fletchmeyers/Automated_Watering_System/README.md

A wireless garden monitoring system using a Raspberry Pi and one or more
radio sensor nodes (CircuitPython and/or Arduino) communicating over RFM69.
The Pi polls nodes, logs data to SQLite, and serves it through a Flask API
behind a Cloudflare Tunnel to a live dashboard on GitHub Pages.

# Setup Guide

This is the current setup as actually deployed — rewritten after a full
disaster-recovery rebuild surfaced a lot of drift from the original guide.
If you're setting up a fresh Pi (new SD card, new hardware), use the
Quick setup below; Parts 1–4 document what it does, step by step. If something here doesn't match reality, it's more likely
this doc that's stale than your memory of how things work — please fix it
inline as you find gaps, the same way this rewrite happened.

---

## Repo layout

```
Automated_Watering_System/
  raspberrypi/     — Pi-side code: radio_nodes.py, flask_api.py, db.py; the Pi's
                     sensors.db and logs also live here (gitignored)
  dashboard/       — the web dashboard (index.html, JS, CSS) served by GitHub Pages
  circuitpython/   — the garden Pico (node 1), laid out like its CIRCUITPY
                     drive: code.py and modules at the top, libraries in lib/
  arduino/         — PlatformIO project for Arduino-based nodes (node 2+)
  deploy/          — systemd unit templates and install.sh
  tests/           — software_tests (pytest) and hardware_tests per board
                     (run them all with: python -m pytest tests/software_tests;
                     the API's need Flask, so they run on the Pi and are
                     skipped elsewhere)
  index.html       — redirects GitHub Pages visitors to dashboard/index.html
```

To update the Pico, copy the contents of `circuitpython/` onto its
CIRCUITPY drive (only the files that changed, usually not `lib/`).

Clone into `~/Automated_Watering_System` on the Pi — every systemd unit,
script, and path reference below assumes this exact location.

## Branches

- **`main`** is the only long-lived branch. GitHub Pages serves the
  dashboard from it, and the Pi's clone tracks it (`git clone <repo-url>`).
- **Sensor data never goes into git.** It lives on the Pi — `raspberrypi/sensors.db`,
  plus the `raspberrypi/data_from_pico.txt` and `raspberrypi/archive/` text logs, all
  gitignored — and reaches the dashboard live through the Flask API.
  (Until October 2026 a cron job pushed `data_from_pico.txt` to a separate
  `update_dashboard_data` branch every 5 minutes; that branch and
  `push_data.sh` are retired.)
- **Workflow for new features**: branch off `main` → develop → open a PR
  into `main` → on the Pi, `git pull` and restart whichever service changed
  (`garden-radio` and/or `garden-api`; if `deploy/` changed, run
  `deploy/install.sh` instead) → confirm it works → delete the
  feature branch. To try a branch on the Pi before merging it, check it out
  there (`git fetch && git checkout <branch>`), then switch back to `main`
  once it's merged.
- **Before deleting a branch on GitHub**, switch your local repo off it
  (`git checkout main && git pull`), then delete the local copy too
  (`git branch -d <branch>`).
- If GitHub Pages' configured source branch (Settings → Pages) ever
  changes, update this section to match — that setting is the actual
  source of truth, this doc is just documentation of it.

## Node IDs

| Node | Hardware | Framework |
|---|---|---|
| 1 | Garden Pico (Pico 2W, solar/car-battery powered) | CircuitPython |
| 2 | Feather M0 | Arduino (PlatformIO) |
| 3+ | any board listed in `nodes.json` (see "Adding or updating a node") | CircuitPython or Arduino |

All nodes share one 915MHz frequency and encryption key — see
`hardware_setup_indoor.py` / `hardware_setup_garden.py` / each
`board_config_*.h`. The key must match exactly across every node and the Pi.

---

## Quick setup (a fresh card)

Works on a Pi 3B or a Pi Zero 2 W. `deploy/setup.sh` does Parts 1–4.

1. **Flash the card** with Raspberry Pi Imager: *Raspberry Pi OS Lite
   (64-bit)*, found under *Raspberry Pi OS (other)*. Lite is the same OS
   without the desktop, which a headless hub doesn't need (the desktop
   costs 200–300 MB of RAM; too much for a Zero 2 W's 512 MB). The full
   OS also works on a Pi 3B; run `sudo raspi-config nonint
   do_boot_behaviour B1` after setup so it boots to the console. In the
   Imager's settings (the gear / "Edit settings"), set the
   hostname, username and password, Wi-Fi, time zone, and turn on SSH.
2. **Copy a backup over**, if you have one (see Disaster recovery). From
   the PC, once the new Pi is on the network:
   ```bash
   scp garden_backup_<date>.tar.gz <user>@<new-pi-ip>:~
   ```
3. **On the new Pi:**
   ```bash
   sudo apt update && sudo apt install -y git
   git clone https://github.com/fletchmeyers/Automated_Watering_System.git ~/Automated_Watering_System
   ~/Automated_Watering_System/deploy/setup.sh --restore ~/garden_backup_<date>.tar.gz --wittypi
   sudo reboot
   ```
   Leave out `--restore` for a brand-new hub with no data or tunnel yet
   (then set up the tunnel per Part 4), and `--wittypi` if there's no
   Witty Pi HAT. The script is safe to re-run if it stops partway.

**Only run one hub at a time.** Two Pis polling the same nodes would
collide on the radio, and two copies of one Cloudflare tunnel would split
the dashboard's requests between them.

## Part 1: OS-level dependencies (not in git — install fresh every time)

None of this is captured by cloning the repo. Do this before anything else
on a fresh Pi:

```bash
sudo apt update
sudo apt install -y swig liblgpio-dev sqlite3
```

**Enable SPI** (required for the radio; off by default on a fresh OS image):

```bash
sudo raspi-config
```

Interface Options → SPI → Yes → reboot.

Confirm it took effect:

```bash
ls -la /dev/spidev0.0
```

## Part 2: Two separate Python environments

These are genuinely separate on purpose — one needs hardware access, the
other doesn't, and mixing them causes `pip install --user` errors (a venv
hides user site-packages).

### 2.1 Radio/hardware venv (for `radio_nodes.py`)

```bash
python3 -m venv ~/env
source ~/env/bin/activate
pip install adafruit-circuitpython-rfm69
```

Verify:

```bash
~/env/bin/python3 -c "import board; print('ok')"
```

### 2.2 Flask API (system Python, no venv)

```bash
deactivate   # if you're still in the venv from above
pip install --user flask flask-cors requests gunicorn --break-system-packages
```

`gunicorn`/`flask` land in `~/.local/bin/` — not on `PATH` by default, so
systemd units below reference full paths rather than bare commands.

## Part 3: systemd services

Four services: `garden-radio` (`radio_nodes.py`, the nodes on the radio),
`garden-wifi` (`wifi_nodes.py`, its counterpart for the nodes on Wi-Fi),
`garden-api` (the Flask API under gunicorn) and `garden-usb` (pulls a
node's backlog when it's plugged in). Templates live in `deploy/`;
`install.sh` fills in your username, installs and enables them, and
(re)starts them all. (`garden-radio` was `garden-sensor`, and
`radio_nodes.py` was `main.py`, until October 2026; `install.sh` removes
the old unit.)
Run it as your normal user — it calls `sudo` itself:

```bash
~/Automated_Watering_System/deploy/install.sh
```

It's safe to re-run after any `git pull` that touches `deploy/`. It also
moves the Pi's data out of the old `indoor/` folder into `raspberrypi/`
if it finds any there (the October 2026 folder rename).

Watch live output:

```bash
sudo journalctl -u garden-radio -f
sudo journalctl -u garden-api -f
sudo journalctl -u garden-wifi -f
sudo journalctl -u garden-usb -f     # nodes plugged in over USB
```

### Weather API keys

`flask_api.py` reads `WEATHERAPI_KEY`, `OPENWEATHERMAP_KEY`,
`TOMORROWIO_KEY` via `os.environ`. Since `garden-api.service` runs under
systemd (not your shell), they live in `/etc/garden-api.env` (readable
only by root, never in git), which the unit loads with `EnvironmentFile=`.
`install.sh` creates it the first time, copying any keys from an older
unit file that had them inline. To edit keys:

```bash
sudo nano /etc/garden-api.env       # one KEY=value per line
sudo systemctl restart garden-api
```

A source with no key configured returns a graceful
"not configured" response rather than erroring, so only set the ones you
actually have keys for.

## Part 4: Cloudflare Tunnel

Not installed by default, and its config lives outside git entirely. This
is the one thing where **losing the credentials file means starting over**
with a brand-new tunnel (new UUID) and re-pointing DNS — so it's worth
backing this up somewhere off the Pi (see Disaster Recovery below).

If restoring an existing tunnel (you have the credentials backed up):

```bash
curl -L --output cloudflared.deb https://github.com/cloudflare/cloudflared/releases/latest/download/cloudflared-linux-arm64.deb
sudo dpkg -i cloudflared.deb
sudo mkdir -p /etc/cloudflared
# copy in: <uuid>.json, cert.pem, config.yml
sudo chmod 600 /etc/cloudflared/<uuid>.json
```

Check `config.yml`'s `credentials-file:` path matches where you actually
put the `.json` — this is the #1 thing that breaks on a restore.

```bash
sudo cloudflared service install
sudo systemctl enable cloudflared
sudo systemctl start cloudflared
```

If starting fully fresh (no backup — creates a **new** tunnel identity):

```bash
cloudflared tunnel login
cloudflared tunnel create garden-api
cloudflared tunnel route dns garden-api api.fletchermeyers.com
```

Then write `config.yml` pointing `service: http://127.0.0.1:5000` at the
Flask API, and proceed with `service install` as above.

Verify end to end:

```bash
curl https://api.fletchermeyers.com/api/health
```

## Part 5: (no cron job or GitHub token needed)

Earlier versions of this guide set up a GitHub push token and a cron job
running `push_data.sh` every 5 minutes. Both are retired: the dashboard
reads data live from the API, and nothing on the Pi pushes to GitHub. The
Pi only needs read access to `git pull`, which a public repo doesn't
require credentials for.

---

## Adding or updating a node

Every node's settings live in the Pi's node list,
**`raspberrypi/nodes.json`**: name, framework (`circuitpython` or
`arduino`), board, Wi-Fi or radio, sense and log intervals, storage (`sd`,
`flash` for Arduino SAMD boards, or `none`), pins, and an optional
`sleep_window`. It's the Pi's own file, not in git (so adding a node never
needs a commit), and it's in both backups (`deploy/backup.sh` and the
nightly USB stick). A fresh Pi starts it from `nodes.example.json`, the two
garden nodes. `radio_nodes.py` takes its node list from it (restart
`garden-radio` after changing it), `wifi_nodes.py` which nodes may connect
over Wi-Fi, the dashboard names and colors (through `/api/nodes`), and
`node_setup.py` builds each node's settings from it. Sensors aren't
listed: both firmwares look for every sensor they know at boot and use
whichever answer.

**Adding a node** — plug the board into the Pi and run:

```bash
cd ~/Automated_Watering_System/raspberrypi
python3 node_setup.py add
```

It asks about the node, with a default for each question (press Enter to
take it): board (skipped when it can tell from what's plugged in),
framework, Wi-Fi or radio, node ID (the lowest one that's free and has no
old readings in the database), name, where it logs, pins (the board's usual
wiring, or your own), how often it reads its sensors, how often it logs
(only with somewhere to log to), RTC and sleep window. Type `b` to go back
a question. At the end it lists every answer with a number: type one to
change it, or press Enter to save. Then it offers to set the board up as
the new node.

**The hardware check** — after setting a board up (new or updated),
`node_setup.py` reads its sensors a few times over USB and lists every one
that answered, with a `!` under any whose readings look wrong: out of
range, a soil sensor at the top of its range or reading as if in air,
readings jumping about (often a noisy USB charger), or a sensor that
stopped answering. A soil sensor that isn't calibrated yet can then take
its dry (or wet) reading on the spot, from about 30 s of live readings
(see "Calibrating soil sensors"). Run the check on its own, with the node
plugged in, with `python3 node_setup.py check`. To check another kind of
sensor, add a row to `CHECKS` in `raspberrypi/sensor_check.py`.

Plain `python3 node_setup.py`
offers the same questions for a board that isn't a node yet. To take a
node off the list (its readings stay): `python3 node_setup.py remove 3`.
Anything the questions don't cover (a `battery` label for the Nodes card,
a different `color`) can be edited in `nodes.json` with `nano`; it's
checked every time it's read.

To update a node to the latest code, plug it into the Pi by USB and run:

```bash
cd ~/Automated_Watering_System/raspberrypi
python3 node_setup.py --dry-run     # see what would change first
python3 node_setup.py               # update it
python3 node_setup.py list          # the nodes in the list
```

It works out which node is plugged in and what it runs. A CircuitPython
board gets the changed files from `circuitpython/` plus the libraries they
use, and a `node_config.py` written from `nodes.json` (and is restarted
from its console if `boot.py` changed). An Arduino board is built with its
settings and flashed. The library `.mpy` files in
`circuitpython/lib` must match the board's CircuitPython major version.

**Switching a board's framework, or giving it another node's ID** — change
`"framework"` in `nodes.json` (`circuitpython` or `arduino`) if needed,
plug it in, and:

```bash
python3 node_setup.py --node 3
```

`nodes.json` says what the node should be, and the script gets the board
there from whatever it runs now. A board without CircuitPython gets
CircuitPython (the version in `nodes.py`, downloaded for its board from
circuitpython.org) before the node code; an Arduino node on a Pico or
Feather RP2040 gets its firmware built with the node's settings and copied
to the board's bootloader drive; the Feather M0 is uploaded over serial.
To reach the bootloader, a board running CircuitPython is restarted from
its console and one running Arduino with a "1200-baud touch". A blank Pico
shows its bootloader drive by itself; otherwise hold BOOTSEL (Pico) or BOOT
(Feather RP2040) as you plug it in.

Boards (`"board"` in `nodes.json`): `pico`, `picow`, `pico2`, `pico2w` and
`feather_rp2040_adalogger` run either framework; `feather_m0`,
`feather_esp32s2` (ESP32-S2 Feather) and `feather_esp32_v2` (ESP32 Feather
V2) are Arduino only. The M0 and ESP32 boards are uploaded over their
serial port: the V2's USB-serial chip resets it for the upload; if the
ESP32-S2 doesn't take the upload (e.g. its factory program ignores the
reset), hold BOOT, tap RESET, release BOOT, and run the script again. On
the RP2 and ESP32 boards the radio uses the board's default SPI pins unless
`spi_sck`/`spi_mosi`/`spi_miso` say otherwise; an SD card on its own bus
(the Adalogger's slot: `sd_sck` 18, `sd_mosi` 19, `sd_miso` 20, `sd_cs` 23)
goes on the RP2 boards' second one. Arduino nodes other than the M0 have no
RTC unless `"rtc": "pcf8523"` is set: their clock is set by the Pi's polls
and nothing is logged after a restart until the first poll, and a sleep
command turns the radio off but keeps the chip awake. A board with
no radio, no I2C sensors or no RTC still runs (USB only), which makes a
bare board easy to test on the bench.

**Wi-Fi, two links, sleep and battery saver** — see
[How nodes reach the Pi](#how-nodes-reach-the-pi-links-sleep-and-battery-saver)
below for every option and command.

**Watchdog** — every node starts the chip's watchdog before it sets up its
radio, sensors and SD card, and feeds it on every pass of its loop, with
every packet it sends, and before anything that waits (joining Wi-Fi,
reaching the Pi). If anything stops the code for too long, such as a
corroded sensor hanging the I2C bus, the board resets itself and carries
on. After a watchdog reset its console says
`[WATCHDOG] Restarted: the code had stopped`.

- **CircuitPython** (`circuitpython/node_watchdog.py`): 8 s. If the code
  crashes it prints the error and resets 5 s later. Ctrl+C at the console
  turns the watchdog off until the next restart, so the console and
  `node_setup.py` work as before; to work at the console for a while
  without it, put an empty file named `no_watchdog` on the CIRCUITPY drive
  (and delete it before the node goes back outside).
- **Arduino** (`arduino/src/node_watchdog.cpp`, the Adafruit SleepyDog
  library): 8 s, or 16 s on the M0 (its Wi-Fi module can take 8 s to join).
  A crash freezes the chip, which the watchdog then resets (an ESP32
  restarts by itself anyway). The M0's standby sleep lasts minutes between
  readings, so the watchdog is paused for standby and resumed on waking;
  the other boards stay awake while "asleep" and keep feeding it. Build
  with `-D NO_WATCHDOG` to leave it off for bench debugging.

**What a node noted** (CircuitPython nodes, `circuitpython/node_events.py`) —
a node keeps a note on its SD card each time it starts (why it restarted:
power on, watchdog or reset; its CircuitPython version; whether USB was
connected), crashes (the end of the error), is stopped at the console, takes
a sensor offline or brings it back, or switches radio format. The radio gets
notes of its own: when a send fails (the radio library returns False, or
raises an error) and when sends work again, with how many failed; and when
nothing at all has been heard over the radio for 10 minutes (the Pi polls
every minute), and when it's heard again. Together they say which way a
link that went quiet was failing: sending, hearing, or neither (then look
at power or range). The notes ride along with its readings,
so the next radio sync or USB pull brings them to the Pi, which keeps them
out of the readings and adds them to `raspberrypi/node_events.txt`:

    tail -n 30 ~/Automated_Watering_System/raspberrypi/node_events.txt

    2026-10-25T12:03:11  node 1  started, reset reason POWER_ON, CircuitPython 10.2.1, no USB

They're also in the log of whichever service brought them in (`garden-radio`
or `garden-usb`) as `[EVENT] Node 1 at ...`. A packet the radio loop can't
read is logged with its size and first bytes (`Bad packet (36 bytes,
starting 85 a1 74 ...)`), so it can be traced to a node.

**A sensor at a time** (`circuitpython/sense_cycle.py`, and `sense_cycle_step()`
in `arduino/src/packet_protocol.cpp`)
— the node reads its sensors one per pass of its loop and checks the radio
in between, so a command arriving mid-cycle waits for one sensor read at
most, not the whole cycle (some reads are slow: the light sensor waits for
a fresh measurement, and a corroded connection drags). Polls get the last
complete set of readings meanwhile. Without this, a node with several I2C
sensors answered pings late (a ping waits 1.5 s) though polls, which retry,
still got through. (Arduino nodes already catch every packet on the radio's
interrupt, through RadioHead, but can't send the answer from inside it, so
they too answer between reads.)

**Sensors with bad connections** (`circuitpython/sensor_guard.py`,
`arduino/src/sensor_guard.cpp`) — the watchdog catches a sensor that hangs
the code outright; this catches one that keeps failing or dragging (pins
going corroded, say) without stopping it. A sensor whose read fails, or
takes over 1 s, **3 times in a row** is taken offline: the node stops
reading it, so the sensors that still work (and the radio) aren't held up.
It tries it again after 10 minutes, 30 minutes, then every hour, and one
good read brings it back; restarting the node tries everything straight
away. The node lists its offline sensors with every poll
(`{"t":"off","s":"sht,s1"}`), the Pi keeps them in `node_info.json` (and
says so in its log), and the dashboard puts a red "Offline since ..."
banner on the sensor's card and lists them in the node's row. The node's
console says `[SENSOR] sht offline: 3 bad reads in a row (the last took
2.3 s)`. The VOC sensor's temperature/humidity compensation uses the SHT40
reading it just took rather than reading the SHT40 again, so a bad SHT40
doesn't drag it down too. A failed read is one the library reports (an
exception in CircuitPython; on Arduino, the SHT40 saying so, 65535 from a
soil sensor, NaN from the battery gauge or power monitors, 0 from the VOC
sensor); the light sensor has no failure value on Arduino, so only slow
reads count for it there. Arduino nodes time their retries on the node's
clock, which keeps counting through the M0's standby sleep.

**Calibrating soil sensors** — out of the box the dashboard shows every
soil sensor on one fixed scale (raw 200 = 0%, 1023 = 100%), which suits
few pots. Calibrate a sensor with two readings in its own soil (not air or
a jar of water: soil reads well inside that range, and differently for
different soils): "dry" while the plant is due for watering, and "wet"
30-60 minutes after watering.

The Pi does it by itself for a soil sensor it hasn't seen before (on a new
node, or a new seesaw on an existing one): put the sensor in dry soil,
wait a few minutes, then water it thoroughly. `garden-api` checks every 5
minutes; it sees the watering as a jump in the readings, takes dry from
just before it and wet from 30-60 minutes after it, and saves both. Until
then the dashboard shows that sensor's gauge in purple with its raw reading
and what it's waiting for ("water it", or "done ~14:20"). Start it for a
sensor by hand (after swapping one, say) with
`python3 node_setup.py calibrate 3 s1 auto`; sensors that were already
there when this first ran are left alone. Or set either end yourself:

    python3 node_setup.py calibrate 3 s1 dry                 # median of the last hour
    python3 node_setup.py calibrate 3 s1 wet --minutes 20
    python3 node_setup.py calibrate 3 s1 dry --until 18:30   # the hour before 18:30
    python3 node_setup.py calibrate 3 s1 dry --value 940     # a reading you already know
    python3 node_setup.py calibrate 3 s1 clear               # back to the fixed scale

It shows the readings it found (how many, the median and how spread out
they are) and asks before saving them to nodes.json (`"soil": {"s1": {"dry":
940, "wet": 610}}`); the dashboard then shows that sensor's dry reading as
0% and its wet one as 100%. An uncalibrated sensor's label has a `*`, and
hovering over it shows the raw reading. Each reading the nodes send is
already the middle of 9 quick ones, so a noisy USB charger's spikes are
thrown out. The hardware check after setup (`python3 node_setup.py
check`) also offers to take either reading from live readings while the
node is plugged into the Pi.

**Bench testing** — don't add test boards to `nodes.json` (`radio_nodes.py` would
start polling them). `tests/hardware_tests/` has bench files with the same
board IDs (9–12) as Arduino or CircuitPython nodes; point the script at one:

```bash
python3 node_setup.py --nodes ../tests/hardware_tests/bench_nodes_arduino.json --node 9
```

A node with a mistake in `nodes.json` is skipped (with a warning) rather
than stopping `radio_nodes.py` or `node_setup.py` from running for the others.

The dashboard reads node names, colors and battery labels from the Pi's
list too (`/api/nodes`; its built-in list is only used if the Pi can't be
reached), so a new node needs no other edits: restart `garden-radio` on
the Pi so it starts polling a radio node (a Wi-Fi node is picked up by
itself).

Flashing Arduino boards needs PlatformIO on the Pi, a one-time install
(`deploy/setup.sh --platformio` does the same):

```bash
curl -fsSL -o get-platformio.py https://raw.githubusercontent.com/platformio/platformio-core-installer/master/get-platformio.py
python3 get-platformio.py && rm get-platformio.py
~/.platformio/penv/bin/pio pkg install -d ~/Automated_Watering_System/arduino
```

The last line downloads every board's compiler and libraries up front (20+
minutes, mostly RadioHead from its author's slow site), so setting up a
node only has to compile: a few minutes for the first build of each board
type on a Pi 3B, a minute or two after that.

---

## How nodes reach the Pi: links, sleep and battery saver

Everything here is set per node in the Pi's `raspberrypi/nodes.json`, by
the `node_setup.py add` questions or the commands below (each is listed in
[the quick reference](#quick-reference) at the end). In every case **the
Pi is in charge**: a node never sends anything on its own, it only answers
the Pi's commands (poll, ping, sync, info, sleep, ...).

### The two links

| | RFM69 radio | Wi-Fi |
|---|---|---|
| On the Pi | `radio_nodes.py` (`garden-radio` service) | `raspberrypi/wifi_nodes.py` (`garden-wifi` service), TCP port 5006 |
| Range | Long (the garden) | The house Wi-Fi's reach |
| Power on the node | Low: about 16 mA listening | High: tens of mA (M0 WiFi) to 80–130 mA (ESP32) while connected |
| Wiring | An RFM69HCW (FeatherWing or breakout): CS, IRQ (G0 on a breakout), RST and SPI | None: the board's own Wi-Fi chip |
| Readings while the Pi can't be reached | Logged to SD (or M0 flash) and synced later | Lost, unless the node also has storage and the radio |
| Speed | Slow; big packets are split | Fast; one JSON line per packet |

### Which boards can use Wi-Fi

| Board (`"board"`) | Arduino | CircuitPython | Notes |
|---|---|---|---|
| `picow`, `pico2w` | Yes | Yes | |
| `feather_esp32_v2` | Yes | No | |
| `feather_esp32s2` | Yes | No | Needs a u.FL antenna |
| `feather_m0_wifi` (Adafruit 3044) | Yes | No | Wi-Fi takes about 18 KB of the M0's 256 KB flash; setup asks first. It looks like a plain `feather_m0` over USB, so `link` asks which it is |
| `pico`, `pico2`, `feather_m0`, Adalogger | No | No | No Wi-Fi chip |

### Choosing a node's links

`"link"` in `nodes.json` is one of:

| `"link"` | Means |
|---|---|
| `"radio"` (or left out) | Radio only. Needs the radio pins. |
| `"wifi"` | Wi-Fi only. No radio pins; storage defaults to none. |
| `["wifi", "radio"]` | Both, Wi-Fi preferred: the radio is the backup. |
| `["radio", "wifi"]` | Both, radio preferred: Wi-Fi is the backup. |

The `node_setup.py add` questions offer these four on a Wi-Fi board. For a
node that's already in the list:

    python3 node_setup.py link 3 wifi radio   # both, Wi-Fi first (asks for the radio pins if it's new to the radio)
    python3 node_setup.py link 3 radio wifi   # both, radio first
    python3 node_setup.py link 3 wifi         # Wi-Fi only

Changing the links changes what's built into the node's code, so **re-flash
it afterwards** (plug it in, `python3 node_setup.py`), and if it just gained
the radio, restart the radio loop so it starts polling it:
`sudo systemctl restart garden-radio`. Where it logs is kept as it was.

### Wi-Fi settings

The node joins the same Wi-Fi network as the Pi. `node_setup.py` gives it
the network name and password (read from the Pi's own NetworkManager
connection, with sudo) and the Pi's address and hostname, **never through
git or the terminal**:

- **Arduino** nodes get them over USB right after flashing, and keep them in
  their own flash: an ESP32's NVS or a Pico W's EEPROM sector (both survive
  re-flashing), or on the M0 WiFi a page of program flash (an upload erases
  it, so they're sent again after every upload).
- **CircuitPython** nodes get them written into `settings.toml` on the
  CIRCUITPY drive (`GARDEN_WIFI_SSID`, `GARDEN_WIFI_PASSWORD`,
  `GARDEN_PI_HOST`, `GARDEN_PI_HOSTNAME`, `GARDEN_PI_PORT`). Code updates
  never touch that file, and anything else in it is kept. They're not the
  usual `CIRCUITPY_WIFI_SSID` names on purpose: those would make
  CircuitPython join by itself and start its web workflow.

If the Wi-Fi password or the Pi's address changes, plug the node in and
re-send them without flashing anything:

    python3 node_setup.py --wifi-only

If the Pi's address has moved, the node also looks the Pi up by name: an
ESP32 as `pi.local` (mDNS), the others through the router's DNS. While a
node can't join the network it prints why on its USB console every 30 s
("network not found", "wrong password?", ...), and keeps trying; the Pico W
and M0 retry the join every 30 s (the M0 backs off to every 5 minutes,
since each try makes it wait up to 8 s).

### Nodes with both links

The node listens on both links and answers each command over the link it
came in on, so which link is used is up to the Pi. Each minute the Pi
polls it over **the first link in its list that's up**
(`raspberrypi/links.py`), and only that one, so no reading is stored twice:

- **Wi-Fi is up** while `garden-wifi` has heard from the node in the last
  3 minutes (it pings a connected node each minute even when the radio is
  in use, to know).
- **The radio is up** while `radio_nodes.py` counts the node as reachable: 3
  missed commands in a row and it's not, until it answers one of the checks
  `radio_nodes.py` sends every 5 minutes. If `radio_nodes.py` isn't running at all, the
  radio counts as down after 3 minutes.
- If neither is up, the first link keeps trying.

So a failover takes about 3 minutes either way. To change which link comes
first, **with no re-flash and no restart** (both services re-read
`nodes.json` within a minute, and each poll tells the node too):

    python3 node_setup.py prefer 3 radio      # or: prefer 3 wifi

Each node's row on the dashboard (click its chip in the header) shows its
link in use right now, e.g. "over Wi-Fi (the radio backup)", and its
Refresh and ping test buttons go over it.

### Radio format: JSON or MessagePack

A radio packet carries at most 60 bytes, so how readings are written
matters. Nodes send JSON over the radio by default; a node can send
**MessagePack** instead, the same readings with the same names in a
binary form about a third smaller (a temperature/humidity reading is 30
bytes instead of 45), so more fits in one packet and fewer have to be split.

    python3 node_setup.py format 3 msgpack     # or: format 3 json to go back

That sets `"radio_format": "msgpack"` in `nodes.json`, and the Pi tells the
node with its next poll (an `m` at the end of the poll's `lp` code), so it
changes, and changes back, with no re-flash; after a restart the node sends
JSON until its first poll. The Pi tells the formats apart by their first
byte (JSON always starts with `{`), so it reads either from any node at any
time, and its own commands stay JSON. USB and Wi-Fi always use JSON. The
node's console says `[RADIO] From the Pi: sending MessagePack over the
radio.`, and its row on the dashboard says "over the radio (MessagePack)".

Needs firmware from October 2026 or later on the node (older firmware just
keeps sending JSON), CircuitPython's built-in `msgpack` module on a
CircuitPython node (a build without it stays on JSON and says so), and the
`msgpack` package in the Pi's radio venv (`~/env/bin/pip install msgpack`;
`setup.sh` installs it).

### Refresh, step by step

**↺ refresh** in a node's row (click its chip in the header to open it)
polls that node over its link in use, and shows each step in the row as it
happens:

| Step (not started → under way → done) | Done when |
|---|---|
| Reach the Pi → Reaching the Pi → Reached the Pi | The Pi's API has the request |
| Send to node → Sending to node → Sent to node | `radio_nodes.py` sent the poll over the radio ("queued" while it finishes whatever it was doing), or `garden-wifi` sent it over Wi-Fi |
| Wait for answer → Waiting for node to answer → Node answered | The first packet of the node's answer arrived |
| Receive readings → Receiving readings → Readings received | Its readings came in (a running count while they do) |
| Save readings → Saving readings → Readings saved | They're in the database (and on the dashboard) |

A step that fails says what didn't happen ("Not sent", "No answer", ...);
one that finished with a caveat says that ("No readings", "Nothing to save").

Grey is a step not started yet, teal the one under way, green done, amber
done with a caveat (or a radio poll sent again because no answer came yet),
and red where it failed, with why: asleep until a given time (it fails at
once, rather than waiting), no answer in 45 s over the radio, not connected
over Wi-Fi, a service not running. A node that answers with no readings (no
sensors answering) ends amber. A clean refresh tidies itself away after a
few seconds; anything else stays until closed (×).

**⇄ ping test** in the same row sends the node 10 pings over its link in
use and opens a box like Refresh's: a dot per ping (green answered, with its
round trip in ms under it; red no answer; teal on its way), then the
average, fastest and slowest. It stays until closed.

**Radio signal.** The Pi measures how strongly each radio packet arrives
(RSSI, in dBm: closer to 0 is stronger). Every 5 minutes the radio loop
logs each node's average (and its weakest packet) and stores them as a
reading (`sig`: `rssi` and `weakest`), so the signal has a history. Each
node's row shows **RADIO SIGNAL**: the latest, *strong* above −80 dBm,
*fair* to −90, *weak* below that, and its average over the dashboard's 6
hours; the analysis panel can plot **Radio Signal (dBm)** and **Radio
Signal · Weakest** like any sensor; and the ping test adds the pongs'
average:

    [SIGNAL] Node 1: -93 dBm (weak) over 12 packets, weakest -99 dBm.

At the radios' 250 kbit/s, packets start getting lost below about −90 dBm:
a node there answers some commands and misses others, and fails pings
first (one try each, where a poll is retried for 45 s). A weak node usually
means its antenna (a loose or cracked joint, the wrong length: 78 mm for
915 MHz), or that something is between it and the Pi. The progress comes from
`/api/poll_progress`, which the Pi's services write as the poll moves along
(`POLL_PROGRESS_FILE` in `sync_indoor.py`).

### Sleep windows

Any node can sleep every night: `"sleep_window": ["19:00", "07:00"]` (Pi's
local time; it may cross midnight), set by the add questions or in
`nodes.json`. Inside the window the Pi sends the node a sleep command (over
the link in use) with its wake time; the node answers, switches its radio
and Wi-Fi off, and wakes at that time (an M0 also puts its chip into
standby; other boards, including CircuitPython nodes, stay awake on their
own clock with the links off). It
still takes a reading every log interval while asleep, and the next day's
sync collects them (nodes with storage). Both services record the sleep in
`node_info.json`, so neither polls a sleeping node or counts it as missing,
and the dashboard shows it as asleep. On waking it rejoins Wi-Fi by itself.

To sleep a node now (bench tests): `python3 sync_indoor.py sleep <node> <minutes>`.
It goes over the node's link in use: over Wi-Fi, `garden-wifi` sends it
straight away and the command says how it went ("asleep until ...", or why
not: it refused and why, it isn't connected); over the radio,
`radio_nodes.py` sends it with its next command (watch
`journalctl -u garden-radio -f`).

A node refuses to sleep (and the Pi asks again later) if its clock isn't
set yet, the wake time has already passed, or it's more than 16 hours away.
While asleep a node only answers Ctrl+C on its USB console (CircuitPython)
or a reset; the Pi leaves it alone until the wake time.

**Low battery: sleeping through a dark day.** A node with a sleep window
and a LiPo on a MAX17048 gauge (its `batt` readings; `"battery"` is `batt`
or not given) sleeps through the day when its battery is low **and** the
day won't charge it. While it's awake outside its window, the Pi sends it
to sleep only when all three agree:

1. **Its battery is low:** a reading from the last 10 minutes under
   **25%**.
2. **The forecasts agree it's dark:** every weather source that answered
   (at least 2 of them; ones older than 3 hours don't count) averages
   **75% cloud or more** over the hours it would sleep through. `garden-api`
   fetches all five every 30 minutes (Open-Meteo and the NWS need no key;
   WeatherAPI, OpenWeatherMap and Tomorrow.io use the keys in
   `/etc/garden-api.env`, and are left out without one) and keeps their
   hourly cloud cover in `/tmp/garden_weather_outlook.json`
   (`raspberrypi/weather_outlook.py`). Too few answers, or one that
   disagrees, and the node stays awake.
3. **Its own light sensor doesn't say it's sunny:** a node with an LTR390
   reading 20,000 lux or more in the last 10 minutes stays awake whatever
   the forecasts say. (Another node's sensor isn't used, since it might
   not be nearby. Arduino nodes send the sensor's raw count rather than
   lux, so the threshold is only rough for them.)

It then sleeps **3 hours at most** and wakes to check in: the Pi polls it
(fresh battery and light readings) and decides again for the next stretch,
so a day that brightens wakes it up to charge. The last stretch ends **15
minutes before its window**, and the window then puts it to sleep for the
night. It isn't sent to sleep within 30 minutes of that check-in.

The log says why either way: `Node 2 asleep until 2026-10-14T10:03:00
(battery 18%, under 25%, dark day)`, or `Node 2's battery is low, but it
stays awake to charge: not all forecasts say it's dark (nws 88%,
weatherapi 40% cloud)`. The dashboard's row shows the reason while it
sleeps.

Change the battery level per node with `"low_battery_sleep": 40` in
`nodes.json`, or turn it off with `false`; then restart `garden-radio`
(the Wi-Fi service picks it up by itself). The cloud and light levels are
`DARK_CLOUD` in `weather_outlook.py` and `SUNNY_LUX` in
`communication_indoor.py`.

### Battery saver

For a node with both links on a small battery: `"battery_saver": true`
keeps **only the link in use powered**, since Wi-Fi draws far more than a
listening radio. What it does depends on which link comes first:

| Links | Battery saver | Radio | Wi-Fi |
|---|---|---|---|
| Both | Off (default) | Always on | Always on |
| Radio first | On | Always on | **Off, and never checked.** If the radio fails, the node can't be reached until it's fixed. |
| Radio first | On, `"wifi_check_hours": N` | Always on | Off, except for 5 minutes every N hours (the first right after boot). If the Pi uses Wi-Fi during a check (which only happens when the radio is down), it stays on while the Pi keeps using it. |
| Wi-Fi first | On | Off while Wi-Fi works; on after 5 minutes without hearing the Pi over Wi-Fi, and off again once the Pi is back on Wi-Fi | Always on |

Details worth remembering:

- Only real commands (polls, sync, ...) count as the Pi using a link; the
  "still there?" pings `garden-wifi` sends don't keep Wi-Fi on.
- **The Pi tells the node its settings with every poll** (which link comes
  first, battery saver on or off, the Wi-Fi check interval), so `prefer`
  and `saver` take effect within a minute, with no re-flash and nothing
  plugged in. After a restart (a power cut, the watchdog) the node uses
  what it was installed with until the Pi's first poll, usually under a
  minute. The settings are packed into a short code to fit a radio packet
  (`"lp"`: `r`/`w` for the link that comes first, a capital letter for
  battery saver, then the check hours, e.g. `R24`).
- After `node_setup.py` gives it new Wi-Fi settings, the node keeps Wi-Fi on
  for 5 minutes even if it's radio first, so setup can see it connect.
- `wifi_check_hours` only matters with the radio first (with Wi-Fi first,
  Wi-Fi is always on anyway).
- To turn it on or off (no re-flash; the node hears it at the next poll):

        python3 node_setup.py saver 2 on                         # Wi-Fi never checked
        python3 node_setup.py saver 2 on --wifi-check-hours 24   # check Wi-Fi once a day
        python3 node_setup.py saver 2 off

- A node can only hear a change over the link it has on. With battery saver
  and the radio first, Wi-Fi is off, so if the radio then fails the Pi has
  no way to reach it until it's fixed (or until its next Wi-Fi check, with
  `wifi_check_hours`).

**Which setting for which spot** (for a node that has both links):

| Where the node is | Setting |
|---|---|
| In the garden, out of Wi-Fi's reach | `link N radio wifi` + `saver N on`: the radio only; Wi-Fi off and never tried. (Or `link N radio` to leave Wi-Fi out of it entirely; that one needs a re-flash.) |
| Indoors, where walls block the radio | `link N wifi radio` + `saver N on`: Wi-Fi, with the radio only listening (cheap) if Wi-Fi goes quiet |
| Somewhere both reach, and power isn't a worry | `link N radio wifi` (or `wifi radio`), battery saver off: both on, the backup ready at once |
| Both reach, on a small battery | battery saver on, with `--wifi-check-hours 24` if it's radio first and you want Wi-Fi tried once a day |

Without battery saver a node with both links keeps **both on all the
time**: it stays joined to Wi-Fi (and keeps retrying if it can't, every 5
minutes at most once it's failing), and the Pi pings it each minute.

  Going down to one link (`link 2 radio`) turns battery saver off, since it
  has nothing left to choose between.

A sleep window and battery saver work together: battery saver decides which
link is on during the day, and at night both are off.

### Quick reference

| Command (in `raspberrypi/`) | What it does | Re-flash? | Restart? |
|---|---|---|---|
| `python3 node_setup.py add` | Add a node (links, battery saver, sleep window among the questions) | Sets it up | `garden-radio`, for a radio node |
| `python3 node_setup.py link N wifi radio` | Change a node's links (in order of preference) | Yes | `garden-radio`, if it gained the radio |
| `python3 node_setup.py prefer N radio` | Change which of its two links comes first | No | No |
| `python3 node_setup.py saver N on [--wifi-check-hours H]` | Battery saver on (or `off`); the node hears it at the next poll | No | No |
| `python3 node_setup.py --wifi-only` | Re-send the Wi-Fi settings to the plugged-in node | No | No |
| `python3 node_setup.py list` | Each node's links, storage and sleep window | | |
| `sudo journalctl -u garden-wifi -f` | Wi-Fi nodes connecting, polls, sleeps | | |
| `sudo journalctl -u garden-radio -f` | Radio polls, pings, sleeps | | |
| `sudo journalctl -u garden-usb -f` | Nodes plugged in by USB, and their backlogs pulled | | |

**After pulling new code on the Pi**, restart the services
(`sudo systemctl restart garden-radio garden-wifi garden-api garden-usb`): running
services keep the old code until then. A Wi-Fi node that's turned away with
"isn't a Wi-Fi node in nodes.json" in `garden-wifi`'s log is usually a
`garden-wifi` still running code from before that board could use Wi-Fi.

## The Pi's power (Witty Pi 4 L3V7)

The Pi runs through a Witty Pi 4 L3V7 UPS HAT: if its USB supply fails it
carries on from the Witty Pi's battery, shuts down cleanly when the battery
gets to the low-voltage threshold (3.1 V by default), and starts again when
the supply comes back ("Auto-On when USB 5V is connected"). That's all the
Witty Pi and UUGear's software (installed with its `install.sh`, set up
with `~/wittypi/wittyPi.sh`); it uses GPIO 4, 17, 5 and 6 and I2C address
0x08, none of which the garden code touches.

`garden-api` also reads it every 30 s (`raspberrypi/pi_power.py`, with
`i2cget` and `pinctrl`):

- The dashboard's **Pi chip**, beside the title: green with the supply
  voltage on USB power (and "charging" while the battery charges), amber
  "on battery 3.90 V · ~80 min left" during a power cut (the time left is a
  rough guess from how fast the battery voltage is falling, after 10
  minutes on battery), red close to the shutdown voltage, "power unknown"
  if it hasn't been read for a few minutes, amber too with a count if
  anything in the Pi's health needs a look. Hover over it for the details,
  click it for the **Pi's row**: its power, CPU temperature, load, memory,
  SD card and uptime; each node's radio signal (the latest, the average and
  weakest in view, and when it was last heard); and its health: the four
  garden services, whether the supply has sagged (under-voltage), the
  clock's sync, and the Witty Pi's temperature (`/api/pi_health`,
  `raspberrypi/pi_health.py`).
- A reading every 5 minutes (and at once when the power source changes),
  stored as node 0's `pipwr`, so the analysis panel can plot the Pi's
  **Supply Voltage**, **Current**, **Battery Voltage**, **On Battery** and
  **Witty Pi Temp**.
- A power cut and the power coming back are logged by `garden-api`
  (`[POWER] power cut: ...`) and added to `node_events.txt` beside the
  nodes' notes:

      tail -n 30 ~/Automated_Watering_System/raspberrypi/node_events.txt

## Syncing a node over USB

For a big backlog (days of readings waiting on a node's SD card), plug the
node into the Pi with a USB data cable: the `garden-usb` service notices it,
asks it what it has waiting, and pulls it over the cable, at hundreds of
lines a second instead of a few. Nothing to run; watch it with
`sudo journalctl -u garden-usb -f`:

```
[USB] Node 1 plugged in on /dev/ttyACM1 with 48,213 bytes waiting; pulling them over USB.
[USB] Done: 612 lines from node 1 in 0.1 min.
```

- It asks a board 5 seconds after it appears (time to start up), and keeps
  asking for up to a minute; a board that never answers (not a garden node,
  or a Pico without `boot.py`) is then left alone.
- Each board is pulled **once per plug-in**. To pull again, unplug it and
  plug it back in, or run it by hand (below).
- A node with nothing waiting (or no SD card) is only noted in the log.
- When the service starts (a reboot, `install.sh`) it treats every board
  already plugged in as just plugged in. An ESP32 V2 restarts when its port
  is opened, so one left plugged into the Pi restarts then too.
- It stays off the USB ports while `node_setup.py` runs, and `node_setup.py`
  waits for a pull under way to finish before it starts.

To pull now, by hand (the service needn't be running):

```bash
cd ~/Automated_Watering_System/raspberrypi
python3 usb_sync.py              # finds the node on any USB serial port
```

`radio_nodes.py` keeps running; while a USB pull runs, it leaves that node's radio
sync alone, and afterwards carries on from wherever the node got to. Lines
are stored exactly as radio sync stores them. Needs `python3-serial`
(installed by `setup.sh`; otherwise `sudo apt install python3-serial`), and
`garden-usb` is installed with the other services by `deploy/install.sh`.

The Pico talks over a second USB port that `circuitpython/boot.py` turns
on, so copy `boot.py` onto it and reset it (unplug, or the reset button)
once before the first USB sync. The M0 needs nothing extra, but must be
awake (not in its overnight sleep), since standby disconnects its USB.

---

## Disaster recovery

Do these **now**, while a card is known-good — not after the next failure.

0. **Backup bundle** — everything on the Pi that isn't in git (the
   database and logs, `node_info.json`, the weather API keys, the
   Cloudflare tunnel credentials and the time zone), in one file that
   `setup.sh --restore` puts back:
   ```bash
   ~/Automated_Watering_System/deploy/backup.sh          # on the Pi
   scp <user>@<pi-ip>:~/garden_backup_<date>.tar.gz .    # on the PC
   ```
   Add `--stop` when moving to a new card: it stops the services first
   (and leaves them stopped), so no readings arrive after the snapshot.
   The bundle contains secrets — keep it off GitHub and other public places.
1. **Full SD card image** of a fully-configured, working card: shut the
   Pi down, put its card in the PC, and in Win32DiskImager pick a file
   name, tick *Read Only Allocated Partitions*, and click *Read*. Restore
   by writing the `.img` to a card of the same size or larger. This is the single highest-leverage backup: it captures
   every apt package, both Python environments, the SPI toggle, systemd
   units, `/etc/garden-api.env`, and cloudflared config in one shot. Restoring an image
   is minutes; rebuilding by hand (what this doc replaces) took days.
2. **Nightly `sensors.db` backups to a USB stick.** Format a stick as
   exFAT with the volume label `GARDENBAK` (on Windows: right-click the
   drive → Format) and leave it plugged into the Pi. `install.sh` sets up
   `garden-backup.timer`, which at 03:30 each night mounts the stick,
   writes a checked, compressed snapshot to `garden_db/sensors_<date>.db.gz`
   and unmounts it again. It keeps 14 nightly copies plus the 1st of each
   month for a year. Run one now, or check the last run:
   ```bash
   sudo systemctl start garden-backup
   sudo journalctl -u garden-backup -n 20 --no-pager
   systemctl list-timers garden-backup     # when the next run is due
   ```
   To restore one: stop `garden-radio`, then
   `gunzip -c sensors_<date>.db.gz > ~/Automated_Watering_System/raspberrypi/sensors.db`,
   delete any `sensors.db-wal`/`-shm` next to it, and start the service.
   (For a one-off copy by hand, use
   `sqlite3 sensors.db ".backup /path/copy.db"`. Never copy `sensors.db`
   directly while `garden-radio` is running: it's a live WAL-mode
   database, and a raw copy can catch it half-written.)
3. **Cloudflare Tunnel credentials** (`/etc/cloudflared/*.json`,
   `cert.pem`, `config.yml`) — back these up somewhere off the Pi. There's
   no way to regenerate the same tunnel identity if lost; only a new one.

## Notes

- **Radio range**: 915MHz RFM69 has limited range, especially through
  walls or with RF interference nearby (construction equipment has
  measurably degraded link quality here before). A struggling link shows
  up as scattered `"ts": "unknown"` packets and low ping-test hit rates —
  this is signal quality, not a bug, and clears up on its own once
  conditions improve.
- **Two data stores**: `data_from_pico.txt` (flat file, used by
  `sensor_health_report()`/`/api/health`) and `sensors.db` (SQLite, used
  by `/api/data` and the actual dashboard) are separate and can drift out
  of sync — a healthy `/api/health` does not guarantee the dashboard has
  data.
- **`archive/`**: intentionally never trimmed/rotated. Not tracked in git
  (would grow the repo unboundedly) — back it up separately if wanted.
- **`__pycache__/` directories**: auto-generated compiled bytecode, safe
  to delete anytime (`find . -name "__pycache__" -type d -exec rm -rf {} +`)
  — they regenerate automatically and should be in `.gitignore`, not
  committed.
