fletchmeyers/Automated_Watering_System/raspberrypi/main.py

'''
Python 3 running on Raspberry Pi 3B

Main loop: poll nodes on a timer, receive sensor bursts, write data to file.
Logged SD data is pulled from nodes in hourly sync sessions between polls.

Written by Fletcher Meyers
March 2026
'''

import json
import time
from pathlib import Path

from hardware_setup_indoor import rfm69, GLED, YLED, RLED, blink_led
from sync_indoor import (
    DATA_FILE, COMMAND_FILE, request_poll, request_sync_chunk, request_info, save_node_info,
    request_command, update_node_info, recorded_wake, SLEEP_REQUEST_FILE,
    POLL_RESULT_FILE, PING_REQUEST_FILE, PING_RESULT_FILE, SYNC_REQUEST_FILE,
    poll_progress, poll_progress_answered, poll_progress_failed, poll_progress_reading,
    poll_progress_sent,
    usb_sync_node,
)

from communication_indoor import (
    CMD_TIMEOUT, CommandManager, BatchReceiver, PollingTimer, FragmentReassembler, SyncManager,
    NodeHealth, SleepScheduler, run_ping_test,
)

import db
from links import NodeList, active_link, write_radio_status
from nodes import link_plan, load_nodes, low_battery_sleep, radio_node_ids, sleep_windows, sync_node_ids

# ── Config ────────────────────────────────────────────────────────────────────
# Nodes come from the Pi's nodes.json (python3 node_setup.py add, then restart).
# Sleep windows: node ID -> ("start", "end") in the Pi's local time; the
# node logs a reading every 5 minutes while asleep and the next day's sync
# collects them. Nodes with "storage": "none" keep no log, so aren't synced.
NODES         = load_nodes(skip_invalid=True)   # a broken entry is skipped, not fatal
NODE_IDS      = radio_node_ids(NODES)   # Wi-Fi-only nodes are polled by wifi_nodes.py
SLEEP_WINDOWS = sleep_windows(NODES)
SYNC_NODE_IDS = sync_node_ids(NODES)

POLL_INTERVAL = 60     # seconds between polls per node
INFO_INTERVAL = 3600   # seconds between storage reports per node
RADIO_STATUS_EVERY = 30   # seconds between writes of which nodes answer (links.py)

SYNC_LINES_PER_HOUR = 2000   # cap per hourly session — a backlog drains over several hours
SYNC_CHUNK_LINES    = 8      # lines per chunk — small, so one lost packet costs little on a weak link

# ── Startup ───────────────────────────────────────────────────────────────────
stale = Path(COMMAND_FILE)
if stale.exists():
    print(f"[STARTUP] Clearing stale command file: {stale.read_text()}")
    stale.unlink()

stale_ping = Path(PING_REQUEST_FILE)
if stale_ping.exists():
    print(f"[STARTUP] Clearing stale ping request file: {stale_ping.read_text()}")
    stale_ping.unlink()

print(f"Temperature: {rfm69.temperature}C")
print(f"Frequency: {rfm69.frequency_mhz}mhz")
print(f"Bit rate: {rfm69.bitrate / 1000}kbit/s")
print(f"Frequency deviation: {rfm69.frequency_deviation}hz")

db_conn = db.get_connection()

sync  = SyncManager(SYNC_NODE_IDS, lines_per_session=SYNC_LINES_PER_HOUR,
                    chunk_lines=SYNC_CHUNK_LINES, db_conn=db_conn)
def on_send(command):
    sync.on_send(command)
    if command.get("t") == "poll":
        poll_progress_sent(command.get("n"), "radio")   # the dashboard's Refresh, if it's waiting


cmd   = CommandManager(on_send=on_send)
batch = BatchReceiver(DATA_FILE, db_conn=db_conn)
timer = PollingTimer(NODE_IDS, poll_interval=POLL_INTERVAL)
info_timer = PollingTimer(NODE_IDS, poll_interval=INFO_INTERVAL)
health = NodeHealth(NODE_IDS)
# Low battery: the newest battery charge (MAX17048 "batt" readings) decides
# whether a node sleeps through the day (nodes.low_battery_sleep).
sleeper = SleepScheduler(
    SLEEP_WINDOWS, low_battery=low_battery_sleep(NODES),
    battery=lambda n, since: db.latest_value(db_conn, n, "batt", "soc", since))


def available(node_id):
    '''Awake and answering — safe to send commands to. A node the Wi-Fi
    service put to sleep is asleep here too (recorded_wake).'''
    return (health.reachable(node_id) and not sleeper.asleep(node_id)
            and recorded_wake(node_id) is None)


# A node with Wi-Fi too is polled over the radio only while the radio is
# the link in use (links.py); its preference is read live from nodes.json.
node_list = NodeList()


def radio_in_use(node_id):
    node = node_list.get().get(node_id)
    return node is None or active_link(node_id, node) == "radio"


def on_radio(node_id):
    '''Available, and the radio is the link in use: polls, sleep commands,
    storage reports and sync all go over the link in use.'''
    return available(node_id) and radio_in_use(node_id)


def node_link_plan(node_id):
    '''A node with both links is told how to use them in each poll.'''
    return link_plan(node_list.get().get(node_id, {}))


radio_status = {"written": None, "at": 0.0}


def share_radio_status():
    '''Tell wifi_nodes.py which nodes answer over the radio (links.py).'''
    reachable = {n: available(n) for n in NODE_IDS}
    if reachable != radio_status["written"] or time.monotonic() - radio_status["at"] >= RADIO_STATUS_EVERY:
        write_radio_status(reachable)
        radio_status.update(written=reachable, at=time.monotonic())


def record_sleep(node_id):
    until = sleeper.asleep_until(node_id)
    update_node_info(node_id, sleep_until=until.strftime("%Y-%m-%dT%H:%M:%S") if until else None,
                     sleep_reason=sleeper.sleep_reason(node_id))
frags = FragmentReassembler()

# ── Main loop ─────────────────────────────────────────────────────────────────
while True:
    share_radio_status()

    # ── A timed-out command counts against its node; a timed-out sync ────
    # ── chunk also ends that node's session for the hour ──────────────────
    # A sleep command is different: no answer usually means it worked.
    if cmd.timed_out is not None:
        if cmd.timed_out.get("t") == "sleep":
            sleeper.timed_out(cmd.timed_out)
            record_sleep(cmd.timed_out.get("n"))
        else:
            health.missed(cmd.timed_out.get("n"))
            if cmd.timed_out.get("t") == "sync":
                sync.abort()
            if cmd.timed_out.get("t") == "poll":
                poll_progress_failed(cmd.timed_out.get("n"),
                                     f"no answer over the radio in {CMD_TIMEOUT} s")
        cmd.timed_out = None

    # ── Manual "sleep now" request (sync_indoor.py sleep) ─────────────────
    sleep_req = Path(SLEEP_REQUEST_FILE)
    if sleep_req.exists():
        try:
            req = json.loads(sleep_req.read_text())
            sleeper.request_now(req["n"], req["minutes"])
        except Exception as e:
            print(f"[SLEEP] Could not parse sleep request: {e}")
        sleep_req.unlink(missing_ok=True)

    # ── Quick check on nodes that stopped answering ───────────────────────
    if cmd.pending is None and not Path(COMMAND_FILE).exists():
        for node_id in health.probe_due():
            if sleeper.asleep(node_id):
                continue
            health.mark_probed(node_id)
            result = run_ping_test(rfm69, node_id=node_id, count=3, report_progress=False)
            if result["hits"]:
                health.heard(node_id)

    # ── Manual "sync now" request (sync_indoor.py sync / API) ─────────────
    sync_req = Path(SYNC_REQUEST_FILE)
    if sync_req.exists():
        try:
            sync.request_now(json.loads(sync_req.read_text()).get("n", 1))
        except Exception as e:
            print(f"[SYNC] Could not parse sync request: {e}")
        sync_req.unlink(missing_ok=True)

    # ── A node being synced over USB (usb_sync.py) is left alone by the ──
    # ── radio sync, including any chunk request already queued or sent ───
    usb_node = usb_sync_node()
    if usb_node is not None:
        sync.release(usb_node)
        queued = cmd.pending
        if queued is None and Path(COMMAND_FILE).exists():
            try:
                queued = json.loads(Path(COMMAND_FILE).read_text())
            except Exception:
                queued = None
        if queued and queued.get("t") == "sync" and queued.get("n") == usb_node:
            cmd.cancel()

    # ── Issue the next poll, sleep, storage report or sync chunk, in ─────
    # ── that order, only to nodes that are awake and answering ────────────
    # Only issue a new command if nothing is currently outstanding, and
    # nothing (e.g. a manual poll from the Flask API) is sitting in
    # COMMAND_FILE waiting to be forwarded. Without this guard,
    # request_poll()/request_sync_chunk() will happily overwrite
    # COMMAND_FILE even while CommandManager is still waiting on an ack for
    # a previous command (automatic OR a manual poll from the Flask API).
    # That overwrite is silent and the Pico never hears about the command it
    # replaced. This was the root cause of polls occasionally vanishing:
    # POLL_INTERVAL and CMD_TIMEOUT are both 60s, so a freshly-due poll and
    # a timeout-cleanup for the previous poll could land in the same loop
    # iteration, and the new command would get wiped out one line after
    # being written — deliberately skipping affected nodes here (rather than
    # calling mark_polled) means they stay "due" and get retried on the next
    # iteration once cmd.pending clears, instead of waiting a full
    # POLL_INTERVAL again. Only one node is polled per iteration for the
    # same reason — a second request_poll() would overwrite the first.
    # Polls come first, so a long sync session never starves them.
    if cmd.pending is None and not Path(COMMAND_FILE).exists():
        for n in timer.due_nodes():
            if not radio_in_use(n):
                timer.mark_polled(n)   # wifi_nodes.py polls it this minute
        due = [n for n in timer.due_nodes() if available(n)]
        info_due = [n for n in info_timer.due_nodes() if on_radio(n)]
        sleep_cmd = sleeper.next_command(on_radio)
        if due:
            request_poll(due[0], link_plan=node_link_plan(due[0]))
            timer.mark_polled(due[0])
        elif sleep_cmd is not None:
            request_command(sleep_cmd)
        elif info_due:
            request_info(info_due[0])
            info_timer.mark_polled(info_due[0])
        else:
            chunk_request = sync.next_command(lambda n: on_radio(n) and n != usb_node)
            if chunk_request is not None:
                request_sync_chunk(chunk_request)

    # ── Run a ping test if one's been requested and nothing else is busy ──
    # Same cmd.pending is None guard as above, for the same reason: a ping
    # burst blocks this loop for up to a couple seconds, so it must not
    # start while CommandManager is mid-flight on something else.
    ping_req = Path(PING_REQUEST_FILE)
    if cmd.pending is None and ping_req.exists():
        try:
            req = json.loads(ping_req.read_text())
        except Exception as e:
            print(f"[PING] Could not parse ping request: {e}")
            req = {}
        node_id = req.get("n", 1)
        count   = req.get("count", 10)
        print(f"[PING] Running ping test: node={node_id}, count={count}")
        try:
            result = run_ping_test(rfm69, node_id=node_id, count=count)
        except Exception as e:
            print(f"[PING] Test failed with exception: {e}")
            blink_led(RLED, times=3)
            result = {
                "count": count, "hits": 0, "misses": count,
                "avg_rtt_ms": None, "results": [], "error": str(e),
            }
        result["node_id"] = node_id   # ← new — so a stale/leftover result can be identified
        Path(PING_RESULT_FILE).write_text(json.dumps(result))
        ping_req.unlink(missing_ok=True)

    # ── Forward any pending command to the Pico ───────────────────────────
    timeout = 6.0 if cmd.pending else 1.0
    cmd.check_and_forward(rfm69)

    # ── Listen for one packet ─────────────────────────────────────────────
    packet = rfm69.receive(with_header=True, timeout=timeout)

    if packet is None:
        continue

    try:
        payload = packet[4:]
        if payload[:1] == b"~":
            # One fragment of a packet too big for a single radio send —
            # wait for the rest before handling it.
            payload = frags.feed(payload)
            if payload is None:
                continue

        data     = json.loads(payload.decode("utf-8"))
        pkt_type = data.get("t")
        # Anything a node sends shows it's reachable. Sync lines carry no
        # "n" — they come from whichever node is being synced.
        health.heard(data.get("n", sync.active))

        if pkt_type == "ts":
            batch.open_batch(data.get("v"))
            poll_progress(data.get("n"), "heard")

        elif pkt_type == "err":
            print(f"[ERROR] Node {data.get('n')} could not send packet "
                  f"q={data.get('q')} ({data.get('sz')} bytes — over radio limit).")
            blink_led(RLED, times=1)

        elif pkt_type == "batch_end":
            # Capture this before handle_ack() clears cmd.pending — we need
            # to know whether the completed batch was a poll response before
            # that state disappears.
            was_poll = (cmd.pending is not None and cmd.pending.get("t") == "poll")

            batch.close_batch(data)
            written = batch.flush(rfm69)
            cmd.handle_ack(data)
            cmd.check_and_forward(rfm69)

            if was_poll:
                # Written even when empty (a node with no sensors answering),
                # so the dashboard's Refresh hears the answer straight away.
                poll_progress_answered(data.get("n"), written)
                try:
                    Path(POLL_RESULT_FILE).write_text(json.dumps(written or []))
                except Exception as e:
                    print(f"[POLL] Could not write poll result: {e}")

        elif pkt_type == "se":
            sync.handle_end(data)
            cmd.handle_ack(data)

        elif pkt_type == "info":
            save_node_info(data)
            cmd.handle_ack(data)

        elif pkt_type == "sleep_ack":
            sleeper.handle_ack(data)
            record_sleep(data.get("n"))
            cmd.handle_ack(data)

        elif cmd.handle_ack(data):
            blink_led(YLED, times=2)

        elif "q" not in data:
            # Logged SD lines are sent as-is — no sequence number, unlike
            # every live packet — so that's what marks them as sync data.
            # One arriving with no chunk outstanding is a late duplicate
            # (the node answered a resend too); it must not be treated as a
            # live reading.
            if sync.awaiting:
                sync.collect(data)
            else:
                print(f"[SYNC] Dropped late sync line: {data}")

        else:
            complete = batch.collect(data)
            poll_progress_reading(data.get("n"))
            if complete:
                batch.flush(rfm69)
                cmd.check_and_forward(rfm69)

        blink_led(GLED, times=1)

    except Exception as e:
        print("Bad packet:", e)
        blink_led(RLED, times=2)
