fletchmeyers/Automated_Watering_System/raspberrypi/sync_indoor.py

'''
Python 3 running on Raspberry Pi 3B

Outbound command functions: poll nodes, request bulk sync, set interval.
Also provides sensor_health_report() for diagnostics.

Usage (while radio_nodes.py is running):
    python3 sync_indoor.py            — request a poll, wait for new data, run health report
    python3 sync_indoor.py sync [N]   — start an SD sync session for node N (default 1) now
    python3 sync_indoor.py info       — show each node's last reported log storage
    python3 sync_indoor.py sleep N M  — put node N to sleep for M minutes now
    python3 sync_indoor.py health     — run health report only
    python3 sync_indoor.py interval N — set sense interval to N seconds

Written by Fletcher Meyers
March 2026
'''

import json
import os
import time
from datetime import datetime, timedelta
from pathlib import Path


DATA_FILE    = Path(__file__).parent / "data_from_pico.txt"
COMMAND_FILE = "/tmp/pico_command.json"

# Fresh poll results, written by radio_nodes.py the instant a poll's batch completes,
# so /api/poll can return real sensor values to the browser straight away.
POLL_RESULT_FILE = "/tmp/pico_poll_result.json"

# Ping test request/result handoff — deliberately separate from COMMAND_FILE
# since the ping loop bypasses CommandManager entirely (see run_ping_test()
# in communication_indoor.py for why).
PING_REQUEST_FILE  = "/tmp/pico_ping_request.json"
PING_RESULT_FILE   = "/tmp/pico_ping_result.json"
# Updated after each individual ping (not just at the end) so the dashboard
# can poll this for a live "x/y pong" readout while a test is running.
PING_PROGRESS_FILE = "/tmp/pico_ping_progress.json"

# Manual "sync now" request — radio_nodes.py's SyncManager picks it up and starts a
# session right away instead of waiting for the next hour.
SYNC_REQUEST_FILE = "/tmp/pico_sync_request.json"

# Manual "sleep now" request — radio_nodes.py's SleepScheduler sends the node a
# sleep command as soon as the radio is free.
SLEEP_REQUEST_FILE = "/tmp/pico_sleep_request.json"

# Held by usb_sync.py while it talks to a node over USB: {"n": node (None
# while it's still finding out which node), "pid": its process}. radio_nodes.py
# leaves that node's radio sync alone until it's gone.
USB_SYNC_FILE = "/tmp/garden_usb_sync.json"
# Held by node_setup.py while it runs ({"pid": ...}): usb_sync.py's watcher
# (the garden-usb service) leaves the USB ports alone until it's gone.
NODE_SETUP_FILE = "/tmp/garden_node_setup.json"


def held_by(path):
    '''What a running process wrote to path to say it's using something, or
    None. A file left behind by a process that died without cleaning up is
    ignored.'''
    try:
        held = json.loads(Path(path).read_text())
        os.kill(held["pid"], 0)        # raises if that process is gone
        return held
    except PermissionError:
        return held                    # running, just as another user
    except (OSError, ValueError, KeyError, TypeError):
        return None


def usb_sync_node():
    '''The node usb_sync.py is syncing right now, or None.'''
    held = held_by(USB_SYNC_FILE)
    return held.get("n") if held else None


# Latest state reported by each node, for the dashboard: {"<node>": {"ub",
# "fb", "tb", "at", "sleep_until"}}. Storage fields are written when an
# "info" reply arrives, sleep_until when a node goes to sleep. Kept next to
# the code rather than in /tmp so it survives a reboot.
NODE_INFO_FILE = Path(__file__).parent / "node_info.json"

WAIT_TIMEOUT = 90   # seconds before giving up waiting for a response


# ── A manual poll's progress (the dashboard's Refresh) ────────────────────────
# flask_api.py starts it; radio_nodes.py (radio) or wifi_nodes.py (Wi-Fi) moves it
# along as the poll goes out and the node answers; /api/poll_progress hands
# it to the dashboard, which draws one step per entry in POLL_STEPS. Each
# step is "wait" (not started), "active", "done", "warn" (done, with a
# caveat: e.g. no readings), "retry" (still going, but sent again) or
# "failed" (the poll ends there), with when it got there ("t", seconds from
# the start) and a "note" to show under it.
POLL_PROGRESS_FILE = "/tmp/garden_poll_progress.json"
POLL_STEPS = ("pi", "sent", "heard", "data", "saved")


def get_poll_progress():
    try:
        return json.loads(Path(POLL_PROGRESS_FILE).read_text())
    except (OSError, ValueError):
        return None


def _write_poll_progress(progress):
    tmp = Path(f"{POLL_PROGRESS_FILE}.{os.getpid()}.tmp")   # each service its own
    tmp.write_text(json.dumps(progress))
    tmp.replace(POLL_PROGRESS_FILE)


def start_poll_progress(node_id, link, request_id=None):
    '''A manual poll of node_id over link ("radio" or "wifi") has reached the Pi.'''
    _write_poll_progress({"id": request_id, "n": node_id, "link": link, "started": time.time(),
                          "end": False, "steps": {s: {"state": "wait"} for s in POLL_STEPS}})
    poll_progress(node_id, "pi")
    poll_progress(node_id, "sent", "active", "queued")


def poll_progress(node_id, step, state="done", note=None):
    '''Move node_id's manual poll (if one is running) to step. A step that's
    done (or warn) also finishes the ones before it, which an answer can
    skip (an empty one has no header), and starts the next.'''
    progress = get_poll_progress()
    if progress is None or progress.get("n") != node_id or progress.get("end"):
        return
    steps = progress["steps"]
    steps[step]["state"] = state
    steps[step]["t"] = round(time.time() - progress["started"], 1)
    if note is not None:
        steps[step]["note"] = note
    i = POLL_STEPS.index(step)
    if state in ("done", "warn"):
        for earlier in POLL_STEPS[:i]:
            if steps[earlier]["state"] not in ("done", "warn"):
                steps[earlier]["state"] = "done"
        if i + 1 < len(POLL_STEPS):
            if steps[POLL_STEPS[i + 1]]["state"] == "wait":
                steps[POLL_STEPS[i + 1]]["state"] = "active"
        else:
            progress["end"] = True
    elif state == "failed":
        progress["end"] = True
    _write_poll_progress(progress)


def poll_progress_failed(node_id, note):
    '''The poll ended without an answer: the step it got to fails, with note.'''
    progress = get_poll_progress()
    if progress is None or progress.get("n") != node_id or progress.get("end"):
        return
    steps = progress["steps"]
    step = next((s for s in POLL_STEPS if steps[s]["state"] not in ("done", "warn")), POLL_STEPS[-1])
    poll_progress(node_id, step, "failed", note)


def poll_progress_sent(node_id, link):
    '''The poll went out to the node (again, if it's a retry).'''
    progress = get_poll_progress()
    if progress is None or progress.get("n") != node_id or progress.get("end"):
        return
    sent = progress["steps"]["sent"]
    if sent["state"] == "done":
        tries = sent.get("tries", 1) + 1
        sent["tries"] = tries
        _write_poll_progress(progress)
        poll_progress(node_id, "heard", "retry", f"sent again (try {tries})")
    else:
        poll_progress(node_id, "sent", note=f"over {'Wi-Fi' if link == 'wifi' else 'the radio'}")


def poll_progress_reading(node_id):
    '''Another reading of the poll's answer has come in.'''
    progress = get_poll_progress()
    if progress is None or progress.get("n") != node_id or progress.get("end"):
        return
    count = progress["steps"]["data"].get("count", 0) + 1
    progress["steps"]["data"]["count"] = count
    _write_poll_progress(progress)
    poll_progress(node_id, "data", "active", f"{count} so far")


def poll_progress_answered(node_id, written):
    '''The node's answer is complete (batch_end) and written is what was stored.'''
    if written:
        poll_progress(node_id, "data", note=f"{len(written)} reading{'s' * (len(written) != 1)}")
        poll_progress(node_id, "saved")
    else:
        poll_progress(node_id, "data", "warn", "no sensors answering?")
        poll_progress(node_id, "saved", "warn")


# ── Outbound commands ─────────────────────────────────────────────────────────

def request_poll(node_id=1, link_plan=None):
    '''
    Write a poll command to the command file.
    Always includes the current time so the Pico silently updates its RTC —
    no separate sync/sync_ack round trip needed for routine clock maintenance.
    link_plan: for a node with both links, how to use them ("lp", from
    nodes.link_plan: which comes first, battery saver; see link_power.h).
    '''
    command = {
        "t":  "poll",
        "ts": datetime.now().strftime("%Y-%m-%dT%H:%M:%S"),
        "n":  node_id,
    }
    if link_plan:
        command["lp"] = link_plan
    Path(COMMAND_FILE).write_text(json.dumps(command))
    # Clear any stale result from a previous poll so wait_for_poll_result()
    # can't pick up an old file before this poll has actually completed.
    Path(POLL_RESULT_FILE).unlink(missing_ok=True)
    print(f"[POLL] Command written: {command}")


def request_bulk_sync(node_id=1):
    '''
    Ask radio_nodes.py to start an SD sync session for node_id now, rather than
    waiting for its next hourly session. The session itself runs in radio_nodes.py
    (SyncManager in communication_indoor.py), one chunk at a time.
    '''
    Path(SYNC_REQUEST_FILE).write_text(json.dumps({"n": node_id}))
    print(f"[SYNC] Sync session requested for node {node_id}.")


def request_sync_chunk(command):
    '''Write one SyncManager chunk request to the command file.'''
    Path(COMMAND_FILE).write_text(json.dumps(command))


def request_sleep(node_id, minutes):
    '''Ask radio_nodes.py to put node_id to sleep for `minutes`, starting now.'''
    Path(SLEEP_REQUEST_FILE).write_text(json.dumps({"n": node_id, "minutes": minutes}))
    print(f"[SLEEP] Sleep requested for node {node_id} ({minutes} min).")


def request_command(command):
    '''Write any prepared command (e.g. SleepScheduler's) to the command file.'''
    Path(COMMAND_FILE).write_text(json.dumps(command))
    print(f"[CMD] Command written: {command}")


def request_info(node_id):
    '''Ask a node how much of its log storage is in use.'''
    command = {"t": "info", "n": node_id}
    Path(COMMAND_FILE).write_text(json.dumps(command))
    print(f"[INFO] Command written: {command}")


def update_node_info(node_id, **fields):
    '''Merge fields into node_id's entry in NODE_INFO_FILE (radio_nodes.py and the
    Wi-Fi service both write it, so it's replaced whole, never half-written).'''
    info = get_node_info()
    info.setdefault(str(node_id), {}).update(fields)
    tmp = NODE_INFO_FILE.with_name(NODE_INFO_FILE.name + ".tmp")
    tmp.write_text(json.dumps(info, indent=2))
    os.replace(tmp, NODE_INFO_FILE)


def record_sensors_off(node_id, names, now=None):
    '''The sensors node_id has taken offline (sensor_guard.py), from a poll's
    answer: kept in NODE_INFO_FILE as {"sensors_off": {name: since}} for the
    dashboard, each keeping the time it first went offline. Says so when one
    goes offline or comes back.'''
    before = get_node_info().get(str(node_id), {}).get("sensors_off") or {}
    stamp = (now or datetime.now()).strftime("%Y-%m-%dT%H:%M:%S")
    after = {name: before.get(name, stamp) for name in names}
    if after == before:
        return
    for name in sorted(set(after) - set(before)):
        print(f"[SENSOR] Node {node_id} took sensor {name} offline: it kept failing or dragging "
              "(a corroded connection?). It retries it every so often.")
    for name in sorted(set(before) - set(after)):
        print(f"[SENSOR] Node {node_id}'s sensor {name} is answering again.")
    update_node_info(node_id, sensors_off=after)


def recorded_wake(node_id, grace_s=90, now=None):
    '''If NODE_INFO_FILE says node_id is asleep (whichever service sent the
    sleep: radio_nodes.py over the radio, or the Wi-Fi service), when it wakes;
    else None. Like SleepScheduler.asleep(), it counts as asleep until
    grace_s after waking.'''
    until = get_node_info().get(str(node_id), {}).get("sleep_until")
    try:
        wake = datetime.strptime(until, "%Y-%m-%dT%H:%M:%S")
    except (TypeError, ValueError):
        return None
    return wake if (now or datetime.now()) < wake + timedelta(seconds=grace_s) else None


def save_node_info(packet):
    '''Record a node's "info" reply in NODE_INFO_FILE.'''
    update_node_info(
        packet.get("n"),
        ub=packet.get("ub"),
        fb=packet.get("fb"),
        tb=packet.get("tb"),
        at=datetime.now().strftime("%Y-%m-%dT%H:%M:%S"),
    )
    print(f"[INFO] Node {packet.get('n')}: {packet.get('ub')} bytes waiting, "
          f"{packet.get('fb')} free of {packet.get('tb')}.")


def get_node_info():
    '''Every node's last storage report, or {} if none yet.'''
    try:
        return json.loads(NODE_INFO_FILE.read_text())
    except (OSError, ValueError):
        return {}


def request_set_interval(seconds, node_id=1):
    '''Write a set_interval command. seconds must be a positive integer.'''
    if not isinstance(seconds, int) or seconds <= 0:
        print("[INTERVAL] seconds must be a positive integer.")
        return
    command = {"t": "set_interval", "v": seconds, "n": node_id}
    Path(COMMAND_FILE).write_text(json.dumps(command))
    print(f"[INTERVAL] Command written: {command}")


def request_ping_test(node_id=1, count=10):
    '''
    Write a ping test request. radio_nodes.py picks this up on its next loop
    iteration (only when nothing else is pending) and runs count back-to-back
    ping/pong round trips, writing the result to PING_RESULT_FILE when done.
    '''
    Path(PING_REQUEST_FILE).write_text(json.dumps({"n": node_id, "count": count}))
    # Clear any stale result/progress from a previous test so the dashboard
    # can't briefly show old data before the new test has actually started.
    Path(PING_RESULT_FILE).unlink(missing_ok=True)
    Path(PING_PROGRESS_FILE).unlink(missing_ok=True)
    print(f"[PING] Test requested: node={node_id}, count={count}")


def wait_for_poll_result(timeout=WAIT_TIMEOUT, node_id=None):
    '''
    Block until POLL_RESULT_FILE appears, then return its parsed packet list.
    Used by /api/poll to hand back real sensor values the moment radio_nodes.py has
    them. With node_id, stops early (None) once that node's poll progress
    has failed: radio_nodes.py gave up on it.
    '''
    print(f"[POLL] Waiting up to {timeout}s for poll result...")
    # [] (written by radio_nodes.py when the node answered with no readings) is an
    # answer too; only None means it never came.
    deadline = time.monotonic() + timeout
    while time.monotonic() < deadline:
        time.sleep(0.3)
        if node_id is not None:
            progress = get_poll_progress()
            if (progress and progress.get("n") == node_id and progress.get("end")
                    and any(s["state"] == "failed" for s in progress["steps"].values())):
                print("[POLL] The radio loop gave up on the poll.")
                return None
        if Path(POLL_RESULT_FILE).exists():
            try:
                packets = json.loads(Path(POLL_RESULT_FILE).read_text())
                print(f"[POLL] Result received ({len(packets)} packets).")
                return packets
            except Exception:
                continue
    print("[POLL] Timed out waiting for poll result.")
    return None


def get_ping_progress():
    '''
    Read the current in-progress ping test state, if any. Returns None if no
    test is running / no progress file exists yet. Cheap, non-blocking read —
    meant to be polled frequently by the dashboard while a test is in flight.
    '''
    try:
        return json.loads(Path(PING_PROGRESS_FILE).read_text())
    except Exception:
        return None


# ── Wait helpers (for use alongside a running radio_nodes.py) ───────────────────────

def wait_for_new_data(timeout=WAIT_TIMEOUT):
    '''
    Block until a new line appears in the data file, then return.
    Used after request_poll() to confirm radio_nodes.py forwarded the command
    and the Pico responded.
    '''
    filepath = DATA_FILE
    try:
        before = filepath.stat().st_mtime if filepath.exists() else 0
    except OSError:
        before = 0

    print(f"[POLL] Waiting up to {timeout}s for new data...")
    deadline = time.monotonic() + timeout
    while time.monotonic() < deadline:
        time.sleep(1)
        try:
            after = filepath.stat().st_mtime
            if after > before:
                print("[POLL] New data received.")
                return True
        except OSError:
            pass
    print("[POLL] Timed out waiting for poll response.")
    return False


def wait_for_interval_ack(timeout=WAIT_TIMEOUT):
    '''
    Block until the command file disappears, indicating radio_nodes.py received
    a set_interval_ack from the Pico.
    '''
    print(f"[INTERVAL] Waiting up to {timeout}s for interval ack...")
    deadline = time.monotonic() + timeout
    while time.monotonic() < deadline:
        time.sleep(1)
        if not Path(COMMAND_FILE).exists():
            print("[INTERVAL] Interval change confirmed.")
            return True
    print("[INTERVAL] Timed out waiting for set_interval_ack.")
    return False


def wait_for_ping_result(node_id=None, timeout=WAIT_TIMEOUT):
    print(f"[PING] Waiting up to {timeout}s for ping test result...")
    deadline = time.monotonic() + timeout
    while time.monotonic() < deadline:
        time.sleep(0.2)
        if Path(PING_RESULT_FILE).exists():
            try:
                result = json.loads(Path(PING_RESULT_FILE).read_text())
                if node_id is not None and result.get("node_id") != node_id:
                    # Leftover result from an earlier, already-abandoned
                    # request for a different node — not ours, keep waiting.
                    continue
                print("[PING] Result received.")
                return result
            except Exception:
                continue
    print("[PING] Timed out waiting for ping test result.")
    return None

# ── Diagnostics ───────────────────────────────────────────────────────────────

def sensor_health_report(filepath=DATA_FILE, n=100):
    '''
    Tail the last `n` lines of `filepath`, count distinct sensor packet types,
    and report how many were seen vs. how many were expected.

    Returns a dict with keys: window, expected, seen, types, missing.
    '''
    _NON_SENSOR_TYPES = {"ts", "se"}
    try:
        with open(filepath, "r") as f:
            lines = f.readlines()
    except FileNotFoundError:
        print(f"[HEALTH] Data file not found: {filepath}")
        return {}

    tail = lines[-n:] if len(lines) >= n else lines
    sensor_packets = []
    for line in tail:
        line = line.strip()
        if not line:
            continue
        try:
            data = json.loads(line)
            if data.get("t") not in _NON_SENSOR_TYPES:
                sensor_packets.append(data)
        except Exception:
            pass

    if not sensor_packets:
        print("[HEALTH] No sensor packets found in the last", len(tail), "lines.")
        return {}

    type_counts = {}
    for pkt in sensor_packets:
        t = pkt.get("t", "unknown")
        type_counts[t] = type_counts.get(t, 0) + 1

    all_types = set(type_counts.keys())

    recent_cutoff = max(1, len(sensor_packets) * 3 // 4)
    recent_types  = {p.get("t") for p in sensor_packets[recent_cutoff:]}
    missing       = sorted(all_types - recent_types)

    report = {
        "window":   len(sensor_packets),
        "expected": len(all_types),
        "seen":     len(all_types),
        "types":    type_counts,
        "missing":  missing,
    }

    print(f"\n[HEALTH] Sensor health report (last {len(tail)} lines, "
          f"{len(sensor_packets)} sensor packets)")
    print(f"  Distinct sensor types : {len(all_types)}")
    for t, count in sorted(type_counts.items()):
        status = " ← possibly offline" if t in missing else ""
        print(f"    {t:12s}  {count:4d} packets{status}")
    if missing:
        print(f"  WARNING: {len(missing)} type(s) absent from recent packets: {missing}")
    else:
        print("  All sensor types present in recent packets.")
    print()

    return report


# ── Entry point ───────────────────────────────────────────────────────────────

if __name__ == "__main__":
    import sys
    args = sys.argv[1:]

    if not args or args[0] == "poll":
        request_poll()
        wait_for_new_data()
        sensor_health_report()

    elif args[0] == "sync":
        node_id = int(args[1]) if len(args) > 1 else 1
        request_bulk_sync(node_id)
        print("[SYNC] Progress is logged by radio_nodes.py — journalctl -u garden-radio -f")

    elif args[0] == "health":
        sensor_health_report()

    elif args[0] == "sleep":
        if len(args) < 3:
            print("Usage: python3 sync_indoor.py sleep <node> <minutes>")
            sys.exit(1)
        request_sleep(int(args[1]), int(args[2]))
        print("[SLEEP] Progress is logged by radio_nodes.py — journalctl -u garden-radio -f")

    elif args[0] == "info":
        info = get_node_info()
        print(json.dumps(info, indent=2) if info else "No storage reports yet.")

    elif args[0] == "ping":
        request_ping_test()
        result = wait_for_ping_result()
        if result:
            print(f"[PING] {result['hits']}/{result['count']} pongs, "
                  f"avg {result['avg_rtt_ms']}ms")

    elif args[0] == "interval":
        if len(args) < 2:
            print("Usage: python3 sync_indoor.py interval <seconds>")
            sys.exit(1)
        try:
            seconds = int(args[1])
        except ValueError:
            print("Interval must be a positive integer.")
            sys.exit(1)
        request_set_interval(seconds)
        wait_for_interval_ack()

    else:
        print("Usage: python3 sync_indoor.py [poll|sync [node]|health|info|sleep <node> <minutes>|ping|interval <seconds>]")
        sys.exit(1)
