fletchmeyers/Automated_Watering_System/circuitpython/communication_garden.py

'''
CircuitPython 10.0.3 running on Pico 2W RP2350

Package sensor data and prepare it for radio and SD write.
Provides send_latest() for poll responses and send_sync_chunk() for Pi-driven SD sync.

Written by Fletcher Meyers
March 2026
'''

import io
import json
import time

# MessagePack over the radio (nodes.json radio_format): CircuitPython's
# built-in module. A build without it just stays on JSON.
try:
    import msgpack
except ImportError:
    msgpack = None

try:
    from hardware_setup_garden import (
        NODE_ID, rfm69, max17, ltr,
        soil_0, soil_1, soil_2,
        sht40, sgp40,
        ina238_0, ina238_1, ina238_2, ina238_3,
    )
except ImportError:
    NODE_ID = None
    rfm69 = None
    max17 = None
    ltr = None
    soil_0 = soil_1 = soil_2 = None
    sht40 = None
    sgp40 = None
    ina238_0 = ina238_1 = ina238_2 = ina238_3 = None


SD_DATA_FILE    = "/sd/data.txt"
SD_SENDING_FILE = "/sd/sending.txt"
SD_CURSOR_FILE  = "/sd/sync_cursor.txt"   # "<generation> <byte offset>" the Pi has confirmed

RADIO_MAX_BYTES     = 60   # RFM69 payload limit with encryption on
FRAGMENT_BODY_BYTES = 45   # leaves 15 bytes for the "~n.msg.i.k|" fragment header
FRAGMENT_GAP        = 0.1  # seconds between fragments, same spacing as normal packets
SYNC_LINE_GAP       = 0.1  # seconds between lines during a sync chunk (radio only)


# ---------------------------------------------------------------------------
# Packet key reference:
# t        = type/sensor tag
# v        = voltage (or set_interval value)
# soc      = state of charge (%)
# m        = moisture
# tmp      = temperature (°C)
# rh       = relative humidity (%)
# voc      = SGP40 raw gas resistance (higher = cleaner air)
# uv       = raw UV count
# uvi      = UV index
# lux      = lux
# ma       = current (mA)
# mw       = power (mW)
# exp      = number of sensors expected in batch
# snt      = number of sensor packets actually sent
# g        = sync file generation (increments each time data.txt is rotated)
# o        = sync byte offset into sending.txt
# c        = lines sent in a sync chunk
# m        = 1 if more sync data is waiting
# k        = max lines requested per sync chunk
# n        = node ID
# q        = sequence number
# ts       = ISO timestamp
# ---------------------------------------------------------------------------


# latest_reading holds the most recent complete sensor snapshot in memory.
# It is a list of packet dicts, one per sensor, set by store_latest_reading().
# The Pi can request this at any time via a "poll" command without touching the SD.
latest_reading = []

# How this node sends over the radio: JSON, or MessagePack when the Pi's
# polls say so ("m" in "lp"). Set by set_radio_format() (code.py, on each
# poll); JSON after a restart until the first poll. USB and Wi-Fi are
# always JSON lines.
radio_msgpack = False


def set_radio_format(use_msgpack):
    global radio_msgpack
    if use_msgpack and msgpack is None:
        if not radio_msgpack:
            print("[RADIO] The Pi asked for MessagePack, but this CircuitPython has no msgpack "
                  "module; staying on JSON.")
        use_msgpack = False
    if use_msgpack != radio_msgpack:
        radio_msgpack = use_msgpack
        import node_events
        node_events.record(f"from the Pi: sending {'MessagePack' if use_msgpack else 'JSON'} over the radio")


def encode_msgpack(obj):
    stream = io.BytesIO()
    msgpack.pack(obj, stream)
    return stream.getvalue()


def decode_packet(payload):
    '''A command as a dict: JSON (starts with "{") or MessagePack.'''
    if payload[:1] == b"{":
        return json.loads(payload.decode("utf-8"))
    if msgpack is None:
        raise ValueError("MessagePack, but no msgpack module")
    return msgpack.unpack(io.BytesIO(bytes(payload)))

# Sensors sensor_guard.py has taken offline (code.py sets it each sense
# cycle): sent with every poll answer so the Pi can show them.
sensors_offline = []


class SerialLink:
    '''
    Stands in for the radio when the Pi talks to this node over USB (the data
    port that boot.py turns on), e.g. to pull a big sync backlog quickly.
    Each packet is one JSON line, with no size limit — so no fragments — and
    no pauses between sync lines.
    '''
    max_bytes = None
    line_gap  = 0

    def __init__(self, port):
        self.port = port
        self._buf = b""

    def send(self, data):
        self.port.write(data + b"\n")

    def receive(self):
        '''Return the next complete command line as a dict, or None.'''
        waiting = self.port.in_waiting
        if waiting:
            self._buf += self.port.read(waiting)
        end = self._buf.find(b"\n")
        if end < 0:
            if len(self._buf) > 1024:
                self._buf = b""   # no newline in sight — not a command, drop it
            return None
        line, self._buf = self._buf[:end].strip(), self._buf[end + 1:]
        if line[:1] != b"{":
            return None
        try:
            command = json.loads(line)
        except ValueError:
            print("[USB] Could not parse:", line)
            return None
        return command if isinstance(command, dict) else None


def feed():
    '''Feeds the watchdog: code.py points this at node_watchdog.feed, so a long
    run of packets (a big sync over USB, say) can't trip it.'''


class PacketSender:
    def __init__(self, node_id, radio):
        self.node_id = node_id
        self.radio = radio
        self.sequence = 0
        self.fragment_id = 0

    def send(self, packet_dict):
        ordered = {"t": packet_dict["t"], "q": self.sequence, "n": self.node_id}
        for k, v in packet_dict.items():
            if k not in ordered:
                ordered[k] = v
        self.sequence += 1

        if self.binary():
            self.send_raw(encode_msgpack(ordered))
        else:
            self.send_raw(json.dumps(ordered, separators=(",", ":")).encode("utf-8"))

    def over_radio(self):
        '''True for the radio; USB and Wi-Fi links have no packet size limit.'''
        return getattr(self.radio, "max_bytes", RADIO_MAX_BYTES) is not None

    def binary(self):
        return radio_msgpack and self.over_radio()

    def send_line(self, line, place):
        '''A logged reading (the JSON line it's kept as) for a sync chunk,
        tagged with its place: as it is, or as MessagePack over the radio.'''
        if self.binary():
            try:
                record = json.loads(line)
                record["j"] = place
                self.send_raw(encode_msgpack(record))
                return
            except ValueError:
                pass   # not a reading after all: send it as it is
        self.send_raw(tag_line(line, place))

    def send_raw(self, data):
        '''
        Send already-encoded bytes, splitting into fragments if they don't
        fit in one radio packet (feeding the watchdog first). Each fragment is prefixed with a short
        plain-text header "~<node>.<msg>.<i>.<k>|" (fragment i of k of message
        msg) that the Pi's FragmentReassembler stitches back together. Plain
        text rather than a JSON wrapper, since embedding JSON inside a JSON
        string would escape every quote and nearly double the size.
        '''
        feed()
        # The radio library returns False when a send doesn't complete (it
        # raises nothing), so that's checked too; USB and Wi-Fi return None.
        ok, error = True, None
        try:
            limit = getattr(self.radio, "max_bytes", RADIO_MAX_BYTES)
            if limit is None or len(data) <= limit:
                ok = self.radio.send(data) is not False
            else:
                parts = [data[i:i + FRAGMENT_BODY_BYTES]
                         for i in range(0, len(data), FRAGMENT_BODY_BYTES)]
                msg_id = self.fragment_id
                self.fragment_id = (self.fragment_id + 1) % 1000
                for i, part in enumerate(parts):
                    header = f"~{self.node_id}.{msg_id}.{i}.{len(parts)}|".encode("utf-8")
                    ok = self.radio.send(header + part) is not False and ok
                    if i < len(parts) - 1:
                        time.sleep(FRAGMENT_GAP)
        except Exception as e:
            ok, error = False, str(e)
            print(f"[ERROR] Radio send failed ({len(data)} bytes): {e}")
        if self.over_radio():
            import node_events
            node_events.radio.sent(ok, len(data), error)   # a note when sends fail, and when they work again

    def send_batch_end(self, expected, sent):
        '''Send a batch_end packet closing out a poll response.'''
        self.send({"t": "batch_end", "exp": expected, "snt": sent})


def store_latest_reading(packets):
    '''
    Overwrite latest_reading with the freshly-read sensor packets.
    Called at the end of each sense cycle in code.py.
    '''
    global latest_reading
    latest_reading = list(packets)


def send_latest(sender, timestamp):
    '''
    Transmit the most recent in-memory sensor snapshot in response to a poll.
    Uses the same burst format as before (ts header → sensor packets → batch_end)
    so the Pi's existing BatchReceiver can handle it unchanged.
    '''
    # Always answer, even with nothing to report: an empty batch_end tells
    # the Pi the node heard the poll, where silence makes it time out and
    # eventually mark the node unreachable.
    packets = list(latest_reading)
    if sensors_offline:
        packets.append({"t": "off", "s": ",".join(sensors_offline)})   # see sensor_guard.py
    if not packets:
        print("[POLL] Nothing to report, sending an empty batch.")
        sender.send_batch_end(expected=0, sent=0)
        return

    sender.send({"t": "ts", "v": timestamp})
    time.sleep(0.1)

    sent = 0
    for pkt in packets:
        try:
            sender.send(pkt)
            time.sleep(0.1)
            sent += 1
        except Exception as e:
            print(f"[POLL] Failed to send packet {pkt.get('t')}: {e}")

    sender.send_batch_end(expected=len(packets), sent=sent)


def append_to_sd(packets, timestamp):
    '''
    Append a sensor snapshot to the SD data file.
    Each packet is written as a JSON line tagged with the batch timestamp.
    '''
    try:
        with open(SD_DATA_FILE, "a") as f:
            for pkt in packets:
                stamped = dict(pkt)      # copy so latest_reading dicts are not mutated
                stamped["ts"] = timestamp
                f.write(json.dumps(stamped, separators=(",", ":")) + "\n")
    except Exception as e:
        print(f"[SD] Write failed: {e}")


def _file_size(path):
    '''Size in bytes, or None if the file doesn't exist.'''
    try:
        import os
        return os.stat(path)[6]
    except OSError:
        return None


def _read_cursor():
    '''Return (generation, offset) the Pi last confirmed, or (0, 0) if none saved.'''
    try:
        with open(SD_CURSOR_FILE, "r") as f:
            gen, offset = f.read().split()
            return int(gen), int(offset)
    except (OSError, ValueError):
        return 0, 0


def _write_cursor(gen, offset):
    try:
        with open(SD_CURSOR_FILE, "w") as f:
            f.write(f"{gen} {offset}")
    except OSError as e:
        print(f"[SYNC] Could not save cursor: {e}")


def tag_line(line, place):
    '''Add "j":<place> to a logged JSON line, so the Pi knows where in the chunk it goes.'''
    if line[:1] == b"{" and len(line) > 2:
        return b'{"j":' + str(place).encode() + b"," + line[1:]
    return line


def send_sync_chunk(sender, command, max_lines=20):
    '''
    Answer one Pi "sync" request with up to max_lines lines from sending.txt,
    followed by an "se" (sync end) packet. The Pi drives the whole transfer
    one chunk at a time, so nothing here blocks waiting on the Pi, and the Pi
    is free to poll other nodes in between chunks.

    Request: {"t":"sync","g":<gen>,"o":<offset>,"k":<max lines>}
      g/o are the generation and byte offset from the previous "se" — sending
      them confirms the Pi has stored everything before o, so the cursor
      advances. Omitting them (e.g. the Pi restarted) resumes from the saved
      cursor instead.
      j (optional) is a bitmask of the lines wanted from this chunk (bit i =
      line i): a retry asks only for the lines that went missing.
    Reply: lines..., then {"t":"se","g":<gen>,"o":<next offset>,"c":<lines>,"m":<0/1>}
      Each line is tagged with its place in the chunk ("j":i) so the Pi can
      tell which ones arrived. c is always the chunk's full line count.
      m = 1 if more data is waiting after this chunk.

    data.txt is renamed to sending.txt when a new transfer starts, so logging
    carries on into a fresh data.txt. The generation number goes up with each
    rename, so a late retry that still carries the previous file's offset is
    recognised and ignored rather than applied to the new file. Reads seek
    straight to the offset, so the chunk cost doesn't grow with file size.
    '''
    import os

    gen, offset = _read_cursor()
    # Only ever move forward: a request carrying an older offset (e.g. the
    # radio side catching up after a USB sync went further) resumes from
    # the saved cursor instead of resending what's already been stored.
    if (command.get("g") == gen and isinstance(command.get("o"), int)
            and command["o"] >= offset):
        offset = command["o"]
        _write_cursor(gen, offset)
    gap = getattr(sender.radio, "line_gap", SYNC_LINE_GAP)
    max_lines = command.get("k", max_lines)
    wanted = command.get("j")
    if not isinstance(wanted, int):
        wanted = None   # no mask: send the whole chunk

    size = _file_size(SD_SENDING_FILE)

    # Previous file fully confirmed by the Pi — delete it and move on.
    if size is not None and offset >= size:
        try:
            os.remove(SD_SENDING_FILE)
        except OSError as e:
            print(f"[SYNC] Could not delete sending.txt: {e}")
        print(f"[SYNC] Generation {gen} fully synced.")
        size = None

    # Start a new generation from whatever has been logged since.
    if size is None:
        data_size = _file_size(SD_DATA_FILE)
        if not data_size:
            sender.send({"t": "se", "g": gen, "o": 0, "c": 0, "m": 0})
            print("[SYNC] Nothing to send.")
            return
        try:
            os.rename(SD_DATA_FILE, SD_SENDING_FILE)
        except OSError as e:
            print(f"[SYNC] Could not rename data file: {e}")
            return
        gen, offset, size = gen + 1, 0, data_size
        _write_cursor(gen, offset)

    sent = 0   # lines in this chunk, whether or not they were asked for again
    try:
        with open(SD_SENDING_FILE, "rb") as f:
            f.seek(offset)
            while sent < max_lines:
                line = f.readline()
                if not line:
                    break
                offset += len(line)
                line = line.strip()
                if not line:
                    continue
                if wanted is None or wanted >> sent & 1:
                    sender.send_line(line, sent)
                    if gap:
                        time.sleep(gap)
                sent += 1
    except OSError as e:
        print(f"[SYNC] Read failed at offset {offset}: {e}")
        return

    more = 1 if offset < size or _file_size(SD_DATA_FILE) else 0
    sender.send({"t": "se", "g": gen, "o": offset, "c": sent, "m": more})
    print(f"[SYNC] Sent {sent} lines (gen {gen}, offset {offset}/{size}).")


def send_storage_info(sender):
    '''
    Report SD usage so the Pi can show it: bytes of log waiting to sync (ub),
    free space on the card (fb) and card size (tb). Same packet as the
    Arduino nodes' handle_info().
    '''
    import os
    used = sum(_file_size(p) or 0 for p in (SD_DATA_FILE, SD_SENDING_FILE))
    try:
        st = os.statvfs("/sd")
        total, free = st[0] * st[2], st[0] * st[3]
    except (OSError, AttributeError):   # no card, or a desktop Python running the tests
        total = free = 0
    sender.send({"t": "info", "ub": used, "fb": free, "tb": total})


# ---------------------------------------------------------------------------
# Sensor read functions
# ---------------------------------------------------------------------------

def package_battery_data(sensor=None):
    s = sensor if sensor is not None else max17
    return {"t": "batt", "v": round(s.cell_voltage, 2), "soc": round(s.cell_percent, 1)}

def package_radio_temp(sensor=None):
    s = sensor if sensor is not None else rfm69
    return {"t": "rt", "tmp": s.temperature}

def package_uv_data(sensor=None):
    s = sensor if sensor is not None else ltr
    return {"t": "uv", "uv": s.uvs, "uvi": round(s.uvi, 2), "lux": round(s.lux, 1)}

# The SHT40's last reading (temperature, humidity, when), which the VOC
# sensor's compensation uses instead of reading the SHT40 a second time: if
# the SHT40's connection goes bad, the VOC sensor isn't dragged down with it.
last_sht = None

def package_sht40_data(sensor=None):
    global last_sht
    s = sensor if sensor is not None else sht40
    temperature, relative_humidity = s.measurements
    last_sht = (temperature, relative_humidity, time.monotonic())
    return {"t": "sht", "tmp": round(temperature, 2), "rh": round(relative_humidity, 1)}

def package_sgp40_data(sensor=None, temp=None, humidity=None):
    s = sensor if sensor is not None else sgp40
    if temp is not None and humidity is not None:
        raw = s.measure_raw(temperature=temp, relative_humidity=humidity)
    else:
        raw = s.raw
    return {"t": "voc", "voc": raw}

def package_ina238_data(sensor_id, sensor=None):
    s = sensor
    return {
        "t": f"pw{sensor_id}",
        "v": round(s.bus_voltage, 3),
        "ma": round(s.current * 1000, 1),
        "mw": round(s.power * 1000, 1),
    }

SOIL_SAMPLES = 9

def moisture(sensor_obj):
    '''The middle of SOIL_SAMPLES quick reads: a few wild ones (from a noisy
    USB charger, say) are thrown away rather than averaged in. Same as
    soil_moisture() in the Arduino node's sensors.h.'''
    reads = sorted(sensor_obj.moisture_read() for _ in range(SOIL_SAMPLES))
    return reads[SOIL_SAMPLES // 2]

def make_soil_fn(sensor_id, sensor_obj):
    def read():
        return {
            "t": f"s{sensor_id}",
            "m": moisture(sensor_obj),
            "tmp": round(sensor_obj.get_temp(), 2),
        }
    return read

def make_sgp40_compensated_fn(sht_sensor, sgp_sensor):
    '''Compensated with the SHT40's reading from this sense cycle (it's read
    first), or uncompensated if there's none from the last minute.'''
    def read():
        if last_sht is not None and time.monotonic() - last_sht[2] < 60:
            return package_sgp40_data(sensor=sgp_sensor, temp=last_sht[0], humidity=last_sht[1])
        return package_sgp40_data(sensor=sgp_sensor)
    return read


# ---------------------------------------------------------------------------
# SENSORS list — ordered list of (name, read_fn) for each available sensor
# ---------------------------------------------------------------------------

SENSORS = []

if rfm69:
    SENSORS.append(("rt", package_radio_temp))
if max17:
    SENSORS.append(("batt", package_battery_data))
if ltr:
    SENSORS.append(("uv", package_uv_data))
if sht40:
    SENSORS.append(("sht", package_sht40_data))
if sgp40:
    if sht40:
        SENSORS.append(("voc", make_sgp40_compensated_fn(sht40, sgp40)))
    else:
        SENSORS.append(("voc", lambda: package_sgp40_data()))

for sid, sobj in [(0, soil_0), (1, soil_1), (2, soil_2)]:
    if sobj:
        SENSORS.append((f"s{sid}", make_soil_fn(sid, sobj)))

for sid, sobj in [(0, ina238_0), (1, ina238_1), (2, ina238_2), (3, ina238_3)]:
    if sobj:
        SENSORS.append((f"pw{sid}", lambda s=sobj, i=sid: package_ina238_data(i, s)))
