fletchmeyers/Automated_Watering_System/arduino/src/node_sleep.cpp

#include "packet_protocol.h"
#include "node_sleep.h"

uint32_t requested_wake = 0;

void handle_sleep(JsonDocument &command, PacketSender &sender) {
  const char *w = command["w"] | "";
  uint32_t wake = 0;
  const char *refused = nullptr;

  if (!clock_valid())                          refused = "clock not set";
  else if (!parse_iso(w, &wake))               refused = "bad wake time";
  else if (wake <= clock_now())                refused = "wake time already passed";
  else if (wake - clock_now() > SLEEP_MAX_S)   refused = "longer than SLEEP_MAX_S";

  JsonDocument doc;
  doc["ok"] = refused ? 0 : 1;
  doc["w"] = w;
  if (refused) doc["why"] = refused;
  sender.send(doc, "sleep_ack");

  if (refused) {
    Serial.print(F("[SLEEP] Refused: "));
    Serial.println(refused);
    return;
  }
  requested_wake = wake;
}

#ifdef BOARD_HAS_RTC

static void on_alarm() {}   // the alarm only needs to wake the chip

void sleep_until(uint32_t wake, RH_RF69 &radio) {
  char ts[20];
  format_iso(wake, ts);
  Serial.print(F("[SLEEP] Radio off, sleeping until "));
  Serial.println(ts);
  Serial.flush();

#ifndef NODE_NO_RADIO
  radio.sleep();
#endif
#if SLEEP_USE_STANDBY
  // SAMD21 errata: letting the flash controller power down in standby can
  // hard-fault the chip on wake. Keep it powered (costs a few µA).
  NVMCTRL->CTRLB.bit.SLEEPPRM = NVMCTRL_CTRLB_SLEEPPRM_DISABLED_Val;
#endif
  rtc.attachInterrupt(on_alarm);

  while (clock_now() < wake) {
    uint32_t next = min(wake, clock_now() + (uint32_t)(LOG_INTERVAL_MS / 1000));
    rtc.setAlarmEpoch(next);
    rtc.enableAlarm(rtc.MATCH_YYMMDDHHMMSS);
#if SLEEP_USE_STANDBY
    // USB activity would wake the chip straight back up — disconnect it
    // for the duration. The computer sees the port vanish and return.
    USBDevice.detach();
    rtc.standbyMode();
    USBDevice.attach();
#else
    // Bench mode: stay awake on a timer so the serial console keeps working.
    while (clock_now() < next) delay(200);
#endif
    rtc.disableAlarm();

    format_iso(clock_now(), ts);
    Serial.print(F("[SLEEP] Woke at "));
    Serial.print(ts);
    format_iso(next, ts);
    Serial.print(F(", alarm was set for "));
    Serial.println(ts);

    // Anything other than the alarm (there shouldn't be anything) just
    // goes back to sleep; only a real alarm takes a reading.
    if (clock_now() >= next) {
      run_sense_cycle();
      node_log_snapshot(clock_now());
    }
  }

  rtc.detachInterrupt();
  // RadioHead puts the radio back in receive mode on its next available().
  Serial.println(F("[SLEEP] Awake, radio back on."));
}

#else

// No RTC to wake the chip from a deeper sleep: switch the radio off and stay
// awake on the millis() clock, still logging every LOG_INTERVAL_MS. Saves the
// radio's share of the power (and keeps the radio quiet, as the Pi expects).
void sleep_until(uint32_t wake, RH_RF69 &radio) {
  char ts[20];
  format_iso(wake, ts);
  Serial.print(F("[SLEEP] Radio off until "));
  Serial.print(ts);
  Serial.println(F(" (no RTC, so the chip stays awake)."));

#ifndef NODE_NO_RADIO
  radio.sleep();
#endif
  while (clock_now() < wake) {
    uint32_t next = min(wake, clock_now() + (uint32_t)(LOG_INTERVAL_MS / 1000));
    while (clock_now() < next) delay(200);
    run_sense_cycle();
    node_log_snapshot(clock_now());
  }
  // RadioHead puts the radio back in receive mode on its next available().
  Serial.println(F("[SLEEP] Awake, radio back on."));
}

#endif
