fletchmeyers/Automated_Watering_System/arduino/src/board_config.h

/*
 * board_config.h
 *
 * Selects the correct board_config_*.h based on a macro set in this
 * environment's build_flags in platformio.ini. packet_protocol.h and
 * arduino_node.ino include this instead of a specific board file, so
 * neither has to know which board it's building for.
 */

#ifndef BOARD_CONFIG_SELECTOR_H
#define BOARD_CONFIG_SELECTOR_H

#if defined(BOARD_FEATHER_M0)
  #include "board_config_feather_m0.h"
#elif defined(BOARD_RP2)
  #include "board_config_rp2.h"
#elif defined(BOARD_ESP32)
  #include "board_config_esp32.h"
#else
  #error "No board selected — set BOARD_FEATHER_M0, BOARD_RP2 or BOARD_ESP32 via build_flags in platformio.ini"
#endif

#endif
