fletchmeyers/Automated_Watering_System/(commit log)

2025-05-30 added python files for BLE communication between Pico W and Pi
2025-06-05 expanded file structure and added flow sensor
2025-06-11 sensor data can now save to the SD card
2026-02-05 added file for checking that the MOSFET can control the fluid solenoid
2026-02-06 Converted main and most hardware test files to circuit python
2026-02-06 added libraries for adafruit sensors
2026-02-16 moved main loop for mcu into a finction in device_setup
2026-03-07 restructured tx/rx code on Pico and Pi, added LED to Pi
2026-03-08 added/fixed unit tests for outdoor mcu
    [battery_monitor.py, blink_led.py, communication_garden.py, device_setup.py, led_test.py, ltr390.py, main.py, max1704x.py]
2026-03-12 added working sync files to pi and pico
2026-03-12 fixed pico radio reset pin bug again
    [communication_garden.py, hardware_setup_garden.py, hardware_setup_indoor.py, main.py, sync_garden.py, test_communication_garden.py, test_hardware_setup_garden.py, test_sync_garden.py]
2026-03-12 fixed reset bug for real this time
    [hardware_setup_garden.py]
2026-03-18 fixed sync timeout bug
    [communication_indoor.py, main.py, set_interval.py, sync_garden.py, sync_indoor.py]
2026-04-04 added html dashboard and some more i2c sensors
2026-04-12 added car battery sensor
2026-04-12 refactored pico packet batching from FAF to FIFO
2026-06-20 updated hardware test for button to control solenoid
2026-06-20 started revision so that the pi requests data packets from the pico and the pico gathers data without sending until it gets a command
2026-06-21 fixed timestamp packet size issue
    [communication_garden.py, main.py]
2026-08-06 fixed race condition with CommandManager
    [main.py]
2026-08-06 decreased cmd timeout to avoid collision
    [communication_indoor.py]
2026-08-09 fixed bug where stale data overwrites refresh data
    [main.py]
2026-08-10 fixed ping test button display bug for mobile browser
2026-08-14 fixed timezone bug in database
    [db.py]
2026-08-15 filtered out unknown timestamp packets from dashboard pt 2
2026-08-17 removed customize button
2026-08-18 fixed some html collisions on mobile and renamed battery sensor fields for clarity
2026-08-20 added day over day overlay and fixed y axis label collision
2026-08-22 fixed some small display bugs and added gitignore file
    [flask_api.py]
2026-09-01 circuit python node listens for its node id before responding to a command
2026-09-03 feather m0 board can now read from i2c sensors and communicate with pi over radio
2026-09-03 cleaned up code and added some more sensors
2026-09-04 added config file for pico and general config file
2026-09-09 temporary bug fix - turned off bulk sync
    [main.py]
2026-09-10 added separate ping test button for different nodes
2026-09-10 fixed node names in dropdown menu
    [flask_api.py]
2026-09-27 Poll M0 node, widen ping timeout, fix push_data.sh paths
    - Add node 2 (Feather M0) to NODE_IDS so the Pi actually polls it; the
    M0 only transmits in response to a poll.
    - Raise run_ping_test() timeout from 0.3s to 1.5s (0.3s caused false
    misses on real round trips).
    - Update push_data.sh from /home/Jules to /home/marsellus after the SD
    card rebuild.
    These three were fixed live on the old SD card but never committed, so
    they were lost when the Pi was re-cloned.
    [communication_indoor.py, main.py]
2026-09-27 Delay M0 replies so the Pi is listening for the first packet
    The M0 answers a command within ~1ms, before the Pi's radio has switched
    from TX back to RX, so the first reply packet was always dropped: every
    pong, and the "ts" header of every poll response (showing up on the Pi as
    "Sensor packet arrived before ts" / ts=unknown). A 50ms pause in
    dispatch_command() before handling any command fixes both.
    [packet_protocol.cpp, packet_protocol.h]
2026-09-27 Replace bulk sync with Pi-driven chunked sync; fragment oversized packets
    The old bulk sync could never finish on the Pico's backlog: it re-read
    sending.txt from the top for every chunk, most SD lines were over the
    60-byte radio limit and silently failed to send, and batch_end's chunk
    counters overflowed the limit too.
    Node side (Pico):
    - PacketSender.send_raw() splits anything over 60 bytes into fragments
    with a "~node.msg.i.k|" header instead of dropping it.
    - send_sync_chunk() answers one {"t":"sync"} request with up to k lines
    from a byte offset (seek, not re-read), then an "se" packet. The cursor
    only advances when the Pi confirms it, and a generation number guards
    against late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
    [code.py, communication_garden.py, communication_indoor.py, hardware_setup_garden.py, main.py, sync_garden.py, sync_indoor.py, test_bulk_sync.py]
2026-09-27 Harden sync on a weak link; add SD card import script
    The garden Pico's link to the Pi drops enough packets that most 20-line
    chunks needed several resends at 10s each, and sessions gave up after
    40-60 lines.
    - Transmit power 13 -> 20 dBm (RFM69HCW max) on the Pi, Pico and M0.
    - Sync chunks shrink from 20 lines to 8 and resend after 4s instead of 10.
    - A sync line arriving with no chunk outstanding (the node answering a
    resend too) is dropped instead of being stored as a live reading with
    ts "unknown".
    - import_sd.py loads a copied SD card log into sensors.db, skipping the
    part of sending.txt the radio sync already delivered. For the ~129 MB
    backlog that filled the Pico's card, whic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
    [arduino_node.ino, communication_indoor.py, hardware_setup_garden.py, hardware_setup_indoor.py, import_sd.py, main.py, test_import_sd.py]
2026-09-27 Add M0 reading log in internal flash, synced like the Pico's SD
    Node side (Arduino):
    - flash_log: records in the top 128 KB of the SAMD21's flash, one 64-byte
    page each (a page is only written once between row erases), found again
    by scanning after a reset and overwriting the oldest when full. The area
    sits beyond the firmware image, so reflashing doesn't wipe it, and the
    node refuses to log if the firmware ever grows into it. The backend is
    chosen per board in board_config_*.h (LOG_FLASH_SAMD or LOG_NONE).
    - The clock (SAMD21 RTC via RTCZero) is set from each poll's timestamp;
    nothing is logged until the first poll.
    - A snapshot is logged every LOG_INTERVAL_MS (5 minutes).
    - "sy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
    [arduino_node.ino, board_config_feather_m0.h, code.py, communication_garden.py, communication_indoor.py, flash_log.cpp, flash_log.h, flask_api.py]
2026-09-27 M0: log to the Adalogger's microSD, keep time on its PCF8523
    The M0 now has an Adalogger FeatherWing (microSD on D10, PCF8523 RTC), so
    its log moves to SD using the Pico's file layout and sync rules
    (data.txt -> sending.txt, byte offsets, sync_cursor.txt). Tested on the
    board: SD mounts, snapshots are written, the first poll sets the RTC.
    - node_log.h/.cpp: one interface over three backends chosen in
    board_config_*.h — LOG_SD, LOG_FLASH_SAMD (the internal-flash log, kept
    for SD-less boards) and LOG_NONE. All three build.
    - The PCF8523 sets the clock at boot when it holds a valid time, and is
    corrected (adjust() also enables coin-cell backup) when a poll shows it
    more than 2s off.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
    [arduino_node.ino, board_config_feather_m0.h, communication_indoor.py, flash_log.cpp, flash_log.h, node_log.cpp, node_log.h, packet_protocol.cpp]
2026-09-27 Stop unreachable nodes from stalling the radio; log Pico SD every 60s
    - NodeHealth: after 3 timed-out commands in a row a node is marked
    unreachable and gets no polls, storage requests or sync chunks — just a
    3-ping check every 5 minutes. Any packet from it restores it. Before
    this, a powered-off M0 cost ~45s of every minute (one outstanding
    command at a time), starving the Pico's polls and sync.
    - Pico SD log every 60s instead of 15s: 15s produced ~1,700 lines/hour,
    nearly the whole 2000-line hourly sync allowance.
    - garden-sensor.service: PYTHONUNBUFFERED=1 so journal timestamps are
    when lines were printed, not when the output buffer flushed. Data
    timestamps are unaffected.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
    [communication_indoor.py, hardware_setup_garden.py, main.py, test_node_info.py]
2026-09-27 README: cut feature branches from main, not the live branch
    Branches cut from update_dashboard_data carry its thousands of "data
    update" commits into main when merged. Cut from main instead, PR into the
    live branch to deploy, then PR the same branch into main.
2026-09-27 Feature node dashboard (#67)
    * Dashboard: per-node cards, header chips, Nodes card, per-node analysis
    Cards were keyed by sensor type alone, so once two nodes reported the
    same type (batt, sht, s0...) a card silently showed whichever node spoke
    last. Everything is now per node.
    - NODES in dashboard.js: name, short name and color per node ID; unlisted
    nodes still appear as "Node N" in a fallback color.
    - Sensor cards are created per sensor per node as data arrives, tinted and
    labelled with their node. Layout prefs (order/hide) work with dynamic
    cards; the storage key is bumped to .v2 since old card IDs don't map.
    - Header: one chip per node with its own status dot and time since its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
    [db.py, test_db.py]
2026-10-01 M0 sleeps through a nightly window, logging to SD with the radio off
    Node (Arduino):
    - "sleep" command {"w": "<wake time>"}: the node answers with sleep_ack
    (or refuses with a reason, e.g. its clock isn't set), switches the radio
    off and goes into SAMD21 standby, woken by the RTC alarm every
    LOG_INTERVAL_MS to take and log a reading, until w. The wake time is
    absolute so a retried command can't push it later; SLEEP_MAX_S (16h)
    guards against a bad one. USB is detached during standby, and the
    flash controller kept powered per the SAMD21 standby errata.
    - -D SLEEP_USE_STANDBY=0 stays awake on a timer instead, for bench tests
    with the serial console working.
    Pi:
    - SleepScheduler: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
    [arduino_node.ino, board_config_feather_m0.h, communication_indoor.py, main.py, node_sleep.cpp, node_sleep.h, packet_protocol.cpp, packet_protocol.h]
2026-10-01 Answer polls even with nothing to report
    With its LiPo unplugged for charging, the M0 had no readings (its only
    sensor is the battery gauge, and vbat is off while the radio CS shares
    D9). send_latest() then sent nothing at all, so every poll timed out and
    the Pi marked a perfectly reachable node as unreachable. Both nodes now
    answer with an empty batch_end, which the Pi already accepts as a
    completed poll.
2026-10-03 Retire the update_dashboard_data branch and the git data pipeline
    The dashboard has read live from sensors.db through the API for weeks, and
    push_data.sh hadn't pushed since 2026-09-03 without anything noticing.
    Everything now lives on main.
    - Delete push_data.sh, and the API's background call to it after a poll.
    - Stop tracking data_from_pico.txt (both copies) and every __pycache__
    file; gitignore them plus indoor/archive/ and sensors.db. main.py
    appends to data_from_pico.txt constantly, which kept the Pi's checkout
    permanently dirty.
    - README: single-branch workflow, no cron job or push token in setup.
    - Drop comments describing the old GitHub/Pages data path.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
2026-10-03 Rename folders to match each board, and add a service install script
    - garden/ -> circuitpython/, next to its lib/, mirroring the CIRCUITPY drive
    - indoor/ -> raspberrypi/ for the Pi code, and the web files -> dashboard/
    - tests/hardware_tests/{outdoor,indoor} -> {circuitpython,raspberrypi}
    - deploy/install.sh fills in and installs both systemd units, moves the
    Pi's untracked data out of the old indoor/ folder, and moves the weather
    API keys into a root-only /etc/garden-api.env
    - Module file names are unchanged; the site root still redirects to the
    dashboard, now at dashboard/index.html
2026-10-03 Add a fresh-card setup script and a backup bundle script
    - deploy/setup.sh turns a fresh Raspberry Pi OS Lite (64-bit) card into the
    hub: packages, SPI/I2C, both Python environments, the garden services,
    and optionally the Witty Pi software. Works on a Pi 3B or Pi Zero 2 W.
    - With --restore it puts back a deploy/backup.sh bundle: data, weather API
    keys, time zone and the Cloudflare tunnel, moving tunnel credentials to
    /etc/cloudflared so a different username doesn't break them.
    - deploy/backup.sh bundles everything not in git; --stop freezes the data
    first for a move to a new card.
    - README: Quick setup section, plus the bundle and SD card image backups.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
2026-10-03 README: where to find Raspberry Pi OS Lite in the Imager
2026-10-03 Nightly sensors.db backup to a USB stick
    - deploy/backup_db.sh snapshots sensors.db as the repo's user, checks the
    copy with PRAGMA quick_check, gzips it onto the GARDENBAK stick, and
    unmounts the stick again so a power cut can't corrupt it
    - keeps 14 nightly copies plus the 1st of each month for 400 days
    - garden-backup.timer runs it at 03:30 (or at the next boot if missed);
    install.sh installs and enables it, and setup.sh adds exfatprogs
2026-10-03 Add import_archive.py to load old archive logs into sensors.db
    Reads any mix of archive files and folders (one JSON packet per line) and
    adds only packets sensors.db doesn't already have, matched on timestamp,
    node and sensor type, so overlapping copies and reruns add nothing twice.
    Skips lines with no timestamp or node and reports why each was skipped.
    --dry-run reports what would be added; --since/--until limit the range.
2026-10-03 Stamp batches with the Pi's clock when their timestamp packet is lost
    BatchReceiver opened a batch with ts="unknown" whenever a poll reply's ts
    packet was dropped by the radio, and those readings went into sensors.db
    with no usable time. Use the Pi's clock instead: the reply arrives within a
    second or so of the poll, whose ts came from that same clock.
2026-10-04 Re-request only the missing lines of a short sync chunk
    Nodes now tag each sync line with its place in the chunk ("j"), and accept
    a bitmask "j" in a sync request naming just the lines wanted. The Pi keeps
    the tagged lines it has, so a short chunk's retry, or CommandManager's
    resend after a lost "se", only asks for what's still missing. The mask
    keeps requests within one radio packet. Untagged lines from older firmware
    are handled as before, by asking for the whole chunk again.
    CommandManager now calls on_send before encoding a command, so the hook
    can set the mask on each resend.
    [communication_garden.py, communication_indoor.py, node_log.cpp, packet_protocol.h, test_bulk_sync.py]
2026-10-04 Sync a node's log over USB
    usb_sync.py on the Pi finds a node on a USB serial port and pulls its whole
    backlog with the same sync requests as the radio side, in 200-line chunks
    with no fragments or pauses, storing lines the same way (store_sync_lines,
    now shared with SyncManager). It holds /tmp/garden_usb_sync.json while it
    runs; main.py then leaves that node's radio sync alone, cancels any chunk
    request already in flight to it, and forgets its cursor so the next radio
    request carries on from the node's own.
    Nodes: the Pico gets a second USB data port (boot.py) and a SerialLink
    that stands in for the radio; the M0's PacketSender can write to Serial,
    and both main loops answer commands that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
2026-10-04 usb_sync: join lines that readline() cut off at its timeout
    pyserial's readline() returns a partial line when its 0.2s timeout hits
    while the node is still writing it, e.g. during an SD read. Both halves
    were then discarded as unreadable, which made a Pico chunk come back
    short over USB (6/7) and cost a retry. Keep the partial line until the
    rest arrives.
    [test_usb_sync.py, usb_sync.py]
2026-10-04 nodes.json as the one node list, and node_setup.py to update nodes over USB
    nodes.json holds each node's name, framework, board, intervals, storage,
    pins and sleep window. main.py now takes its node IDs, sleep windows and
    sync list from it (raspberrypi/nodes.py loads and checks it).
    raspberrypi/node_setup.py updates whichever node is plugged into the Pi:
    a CircuitPython board gets the changed files from circuitpython/, the
    libraries they use, and a node_config.py generated from nodes.json; an
    Arduino board is built with -D flags from nodes.json and flashed with
    PlatformIO. --dry-run shows the plan; --node N sets up a new board.
    hardware_setup_garden.py reads node_config.py (today's values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
2026-10-04 Install CircuitPython on new boards from the Pi; dashboard reads nodes.json
    node_setup.py --install --node N puts CircuitPython 10.3.1 on a board and
    sets it up as node N: it finds the board's UF2 bootloader drive (RPI-RP2,
    RP2350 or FTHRS2BOOT) or restarts a CircuitPython board into it from its
    console, checks the chip matches nodes.json, downloads that board's UF2
    from circuitpython.org (cached), and copies it over. ESP32-S2 boards with
    a TinyUF2 too old for CircuitPython 10 are refused with instructions.
    After an update that changes boot.py, the board is reset from its console.
    nodes.py gets a board catalogue: pico, picow, pico2, pico2w, Feather
    RP2040 Adalogger and ESP32-S2 for CircuitP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
    [code.py, hardware_setup_garden.py, node_setup.py, nodes.py, test_node_config.py]
2026-10-04 Pico code: a bad SPI pin in nodes.json leaves the board running
2026-10-04 node_setup: find library dependencies, check the console, explain failures
    - Libraries are no longer hand-listed: required_libs() scans the node code
    and then each library it uses for the names of other libraries. The hand
    list missed adafruit_ina228, which adafruit_ina23x imports, so a fresh
    Pico 2 crashed at startup with an ImportError.
    - run_on_console() only types once it sees the ">>>" prompt, trying each
    of the board's ports, and returns what the board printed.
    - After an update the node gets up to 40s to answer; if it doesn't, its
    console output from restarting code.py (e.g. a traceback) is shown.
    [node_setup.py, test_node_config.py, usb_sync.py]
2026-10-04 node_setup: wait for the console while the board reloads; always check the node
    - run_on_console()/console_output() keep trying for up to 15s to reach the
    REPL prompt. Straight after files are written the board is reloading and
    ignores Ctrl-C, so a Pico's restart after boot.py was skipped and its
    USB data port never appeared.
    - An update with nothing to copy still checks the node answers, so a
    plain node_setup.py run doubles as a health check.
    - Pico code: with no I2C bus, sensors are skipped quietly instead of each
    printing its own error.
    [hardware_setup_garden.py, node_setup.py, test_node_config.py]
2026-10-04 Drop CircuitPython on ESP32 boards; clearer bootloader button wording
    The ESP32-S2 Feather (#6282) shipped without the TinyUF2 bootloader that
    CircuitPython installs need, and ESP32 nodes will run Arduino anyway. Its
    board entry stays, for Arduino. The 'no bootloader drive' messages now say
    to hold the board's BOOTSEL/BOOT button while plugging it in.
2026-10-04 Arduino on RP2040/RP2350 boards, and switching frameworks from the Pi
    Firmware:
    - board_config_rp2.h for the Pico, Pico W, Pico 2, Pico 2 W and Feather
    RP2040 Adalogger (Arduino-Pico core; PlatformIO envs per board). No RTC
    by default: the millis() clock is set by polls; "rtc": "pcf8523" in
    nodes.json adds the PCF8523. Radio on the board's default SPI, or other
    pins from nodes.json; an SD card on its own bus (the Adalogger's slot)
    goes on SPI1.
    - The sensors shared by every board move to sensors.h; the M0 keeps its
    battery divider. Built with node 2's flags the M0 firmware is unchanged
    except for the next point.
    - A node with no radio keeps running over USB instead of halting a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
2026-10-06 Bench test files instead of editing nodes.json; skip bad node entries
    - node_setup.py --nodes FILE uses another nodes file. tests/hardware_tests/
    has bench_nodes_arduino.json and bench_nodes_circuitpython.json: the same
    test boards (IDs 9-12) as either framework, so testing needs no edits to
    the Pi's nodes.json (and main.py never polls them).
    - load_nodes(skip_invalid=True) leaves out a node with a mistake, with a
    warning. main.py and node_setup.py use it, so one bad entry (e.g. a stale
    test entry) can't stop the radio loop or setting up another node.
    [main.py, node_setup.py, nodes.py, test_node_config.py]
2026-10-06 setup.sh --platformio downloads every board's compiler and libraries
    pio pkg install for the whole arduino project, so a node's first setup
    from the Pi only compiles instead of spending 10-20 minutes downloading.
    README gives the same command for a Pi that already has PlatformIO.
2026-10-06 Analysis plots on phones: legend above instead of axis titles; distinct colors
    - Below 600px of plot width (time series, trend, rate of change) the
    per-axis titles are dropped, the legend goes above the plot with each
    entry colored like its line and axis, extra axes pack tighter, tick
    labels are smaller, the x axis has fewer (level) ticks, and the Plotly
    toolbar is hidden. Desktop is unchanged.
    - Checked fields now pick colors together so no two lines in a plot share
    one; checkbox swatches follow. The palette's near-identical second green
    and the text-colored grey are replaced with pink and light grey.
2026-10-06 Analysis plots: shared axes by unit, legend on top, phone zoom toggle, redraw on resize
    - Fields with the same unit share one axis (grey, titled by the unit) when
    "Shared axes" is on (the default), for time series, trend and rate of
    change; off gives one axis per field as before.
    - Fix the empty strip right of the plot: the stacked right-hand axes'
    width was reserved twice, in the x domain and again as page margin.
    - The legend sits above every plot, each entry colored like its line.
    - On a phone, dragging on the plot scrolls the page; a Zoom button turns
    zooming on.
    - The last multi-axis plot is redrawn for a new width (e.g. a phone
    turned sideways) without refetching.
    Co-Authore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
2026-10-06 Arduino on the ESP32-S2 Feather and ESP32 Feather V2
    - board_config_esp32.h (Espressif Arduino core 2.0.x; PlatformIO envs
    feather_esp32s2 and feather_esp32_v2). Powers the STEMMA QT port at boot
    (PIN_I2C_POWER / NEOPIXEL_I2C_POWER), so I2C sensors are found; no RTC
    (millis clock set by polls, radio-off sleep); the V2 reports vbat from
    its battery monitor pin. Radio on the default SPI pins or spi_* from
    nodes.json.
    - nodes.py: both boards take Arduino; custom radio pins allowed on ESP32.
    node_setup.py uploads them over serial like the M0.
    - usb_sync.open_port() holds DTR/RTS off on USB-serial chips (CH9102,
    CP210x, FTDI), so probing an ESP32 V2 doesn't reset it.
    - Bench file ga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
    [arduino_node.ino, board_config.h, board_config_esp32.h, nodes.py, test_node_config.py, usb_sync.py]
2026-10-06 Wi-Fi nodes: ESP32 boards that talk to the Pi over Wi-Fi instead of the radio
    Firmware (-D NODE_LINK_WIFI, ESP32 only): no radio; joins Wi-Fi and opens
    a TCP connection to the Pi's garden-wifi service, says hello, then answers
    the Pi's commands with the usual packets, one JSON object per line (the
    USB line reader is now a LineReader shared by both). Wi-Fi name, password
    and the Pi's address come over USB ({"t":"wifi_config"}, USB only) and
    live in the board's NVS; if the saved address fails it looks the Pi up
    by name over mDNS. wifi_link.cpp is left out of non-ESP32 builds.
    - wifi_nodes.py / garden-wifi.service: asyncio server on port 5006;
    accepts only nodes.json Wi-Fi nodes (re-read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
    [arduino_node.ino, main.py, node_setup.py, nodes.py, packet_protocol.cpp, packet_protocol.h, test_wifi_nodes.py]
2026-10-06 node_setup: send Wi-Fi settings in the same port session; --wifi-only
    The ESP32 V2's USB-serial chip can reset the board when its port is
    closed or opened, so checking the node and then reopening the port to send
    the Wi-Fi settings hit it mid-boot ("Couldn't reach the node over USB").
    send_wifi_config() now asks which node it is on one open port, retrying
    for up to 15s while it boots, and sends the settings on that same session.
    --wifi-only re-sends a Wi-Fi node its settings without flashing it.
    [node_setup.py, test_node_config.py, test_wifi_nodes.py]
2026-10-06 usb_sync: give a board on a USB-serial chip time to boot when probing it
    Opening a CH9102/CP210x/FTDI port on Linux briefly raises DTR/RTS before
    they can be held off, resetting an ESP32 V2, so it missed the 3s "info"
    probe and node_setup said it wasn't a node yet. For those chips find_node
    keeps asking on the same open port for up to 12s.
    [test_usb_sync.py, usb_sync.py]
2026-10-06 Longer command lines on Arduino nodes; show why Wi-Fi settings failed
    - LineReader holds 768 characters (was 160): the Wi-Fi settings line is
    101 characters plus the password, so a long password overflowed it and
    the board dropped the line silently. It now also says when it drops one.
    - node_setup.py says whether the node didn't answer or didn't confirm the
    settings, and shows the board's last lines of output (UsbNode.chatter),
    which would include an ESP32 crash report.
    - A test checks the longest possible settings line fits the buffer.
    [node_setup.py, packet_protocol.cpp, packet_protocol.h, test_wifi_nodes.py, usb_sync.py]
2026-10-10 Keep the node list on the Pi, with questions to add a node
    The node list moves out of git to raspberrypi/nodes.json on the Pi (and
    into both backups). A fresh Pi starts it from nodes.example.json, or from
    the old repo-root nodes.json if one is left.
    node_setup.py add asks about a new node with a default for each question
    (board, framework, Wi-Fi or radio, the lowest free ID with no old
    readings, name, storage, pins, intervals, RTC, sleep window), saves it and
    offers to set up the plugged-in board. A board that isn't a node yet is
    offered the same questions; node_setup.py remove N takes one off.
    The dashboard reads names and colors from the new /api/nodes (no pins),
    and its ping test only l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
2026-10-10 Dashboard: refresh and ping Wi-Fi nodes; combine cards by drag and drop
    The header's node menu now lists every node, and both Refresh and the ping
    test act on the chosen one. /api/poll and /api/ping_test take a node_id:
    radio nodes still go through main.py; Wi-Fi nodes go through garden-wifi's
    new control port (127.0.0.1:5007), which polls or pings the node over its
    open connection, holding a per-node lock so the scheduled poll and a
    dashboard request never read each other's replies.
    Dropping a sensor card on the middle of another combines them into one card,
    each display keeping its own heading and handle; dragging one back out onto
    the edge of a card gives it its own card again. Combined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
2026-10-10 Dashboard: compact combined cards, move cards on drop, pack the grid
    A combined card is now the size of a normal card: one heading with the
    sensor's title and a chip per node (also the handle for taking a display
    back out), and each node's display without its own frame. Combined soil
    cards put every node's gauges in one grid, each labelled with its node, so
    four gauges fit in a single-column card.
    Dragging no longer moves cards around mid-drag (which shifted the card you
    were aiming for): a green bar shows where the card will go, or a dashed
    outline that it will be combined, and it happens on drop.
    The grid packs cards by their own height, so the tall Nodes card no longer
    stretches the res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
2026-10-10 Dashboard: node details and weather as rows above the cards; tint gauges
    The Nodes card is gone: clicking a node's chip in the header opens a
    full-width row below it with that node's battery and storage, its radio (or
    Wi-Fi) and system readout, and its sensor health (no longer separate
    cards). Rows stack in the order they're opened and close with their x or
    the chip again; which are open is remembered.
    The weather forecast is a full-width row under those, above the cards; its
    title folds it away.
    Soil gauges are tinted with their node's color, so a combined card's nodes
    are easy to tell apart. Saved layouts drop the cards that have left the grid.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
2026-10-10 Dashboard: shorter node and weather rows; one node tint for every box
    Node rows: the name, battery and storage now share the top line with the
    close button, radio/system readings sit side by side, and sensor health
    wraps into as many columns as fit.
    Weather row: the title, today's conditions, the days ahead and the source
    picker are on one line on a wide screen, with smaller day tiles; on a phone
    the forecast drops under the title.
    Every box inside a node's card or row (soil gauges, readings, power
    monitors, UV) takes the same tint of the node's color, in a combined card
    too.
2026-10-10 Dashboard: pick node and line colors; tidier weather and analysis controls
    Node colors: a node's details row has a color swatch that changes its color
    everywhere on the page (chip, cards, tints, analysis rows), kept in this
    browser, with a button back to the node list's color.
    Analysis: a field gets a color only once it's picked (the first one no
    other picked field is using) and keeps it while other fields come and go.
    A picked field's swatch opens a color picker; the choice is remembered.
    "Clear selection" unpicks every field. Shared axes moved next to Plot.
    Weather: the source picker sits under the title and the temperature badge
    is gone (the row already shows it), leaving the forecast m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
2026-10-10 Wi-Fi nodes on the Pico W and Pico 2 W (Arduino)
    wifi_link.cpp now builds for the Arduino-Pico core as well as the ESP32:
    settings kept in the core's EEPROM sector, rejoining every 30 s (the core
    doesn't on its own), and the Pi found by name through the router's DNS.
    Every Wi-Fi node now says why on USB every 30 s while it can't join.
    nodes.py lists the boards with a Wi-Fi chip (WIFI_BOARDS) and the
    frameworks with Wi-Fi so far; the checks and the add-a-node questions use
    it. The picow/pico2w PlatformIO envs include wifi_link.cpp, and the RP2
    envs ignore iLabs Hearth, whose Preferences.h the library finder would
    otherwise pull in.
2026-10-10 Soil sensors: per-sensor calibration and a median filter
    Each soil reading the nodes send is now the middle of 9 quick touch reads
    (sensors.h on Arduino, communication_garden.py on CircuitPython), so a few
    wild ones from a noisy USB charger are thrown away.
    nodes.json can carry each soil sensor's raw reading in dry and in
    just-watered soil ("soil": {"s1": {"dry": 940, "wet": 610}}), and
    /api/nodes passes it on: the dashboard shows dry as 0% and wet as 100%,
    and an uncalibrated sensor keeps the old fixed scale with a * on its
    label. node_setup.py calibrate N sX dry|wet|clear sets one end from the
    median of the sensor's readings in sensors.db over a window (--minutes,
    --until) or a given --va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
2026-10-10 Hardware check after node setup, with soil calibration from live readings
    sensor_check.py polls the plugged-in node a few times over USB and lists
    every sensor that answered, flagging readings that look wrong: out of
    range (a table per sensor, CHECKS), a soil sensor saturated, in air,
    jumping about or no longer answering, or no sensors at all. node_setup.py
    runs it after every setup, and on its own as node_setup.py check.
    For each soil sensor that answered without both calibration points, it
    offers to take the dry or wet reading there and then from ~30 s of live
    readings (the median), and says which command takes the other one later.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
2026-10-11 Dashboard: faster loads, live analysis plots, clearer plot buttons
    Speed:
    - /api/data's minutes window compared the stored "...T12:00:00" times
    against datetime()'s "... 12:00:00", so it returned everything since
    midnight: a "last 5 minutes" request sent ~8000 packets. It now uses the
    same "T" form.
    - /api/data returns a cursor (the newest rowid); the cards' 10 s refresh
    then asks only for rows added since (after=), not the whole window.
    - /api/available_fields kept between requests (db.AvailableFields),
    worked out once at startup and then only from new rows: it was a ~20 s
    full-table scan on every page load, holding up the analysis panel.
    Analysis panel:
    - Time window / Live da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
2026-10-11 Soil sensors calibrate themselves; quieter plot buttons
    A soil sensor the Pi hasn't seen before (a new node, or a new seesaw on an
    existing one) starts calibrating by itself: put it in dry soil, then water
    it thoroughly. garden-api checks every 5 minutes (soil_calibration.py):
    the watering shows as a jump in the readings, dry is the median just
    before it and wet the median 30-60 minutes after, and both are saved to
    nodes.json. Sensors already there when it first runs are left alone
    (soil_sensors_seen.json, the Pi's own). node_setup.py calibrate N sX auto
    and the hardware check start it by hand.
    Meanwhile the dashboard draws that gauge in purple with its raw reading
    and what it's waiting for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
2026-10-11 node_setup.py link: change which links an existing node has
    node_setup.py link N wifi radio gives a node Wi-Fi and the radio (or just
    one), in order of preference, asking for the radio pins if it's gaining
    the radio (the board's usual ones offered first). Where it logs is kept as
    it was, so a Wi-Fi node with no storage setting doesn't turn into one
    expecting an SD card. The board then needs re-flashing.
2026-10-11 Wi-Fi on the Feather M0 WiFi (ATWINC1500)
    wifi_link.cpp gains a third Wi-Fi path, for the Feather M0 WiFi (Adafruit
    3044): WiFi101 on the ATWINC1500 (CS 8, IRQ 7, RST 4, EN 2), the settings
    in a page of flash (FlashStorage; an upload erases it, and node_setup.py
    re-sends them after every upload), and the Pi found by name through the
    router's DNS. WiFi101 can only join by waiting, so each try is capped at
    8 s and failed tries back off from 30 s to 5 minutes, keeping the radio
    listening while Wi-Fi is out of reach. The sketch holds the module's CS
    high at boot so it can't upset the shared SPI bus. Its own env,
    feather_m0_wifi; Wi-Fi adds about 18 KB (95 -> 113 KB).
    On the Pi: a feather_m0_wif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
2026-10-11 Sleep windows for nodes with Wi-Fi; battery saver keeps one link on
    Any node can now have a nightly sleep window, Wi-Fi or not. The sleep
    command goes over the link in use: main.py's SleepScheduler for radio,
    and the same scheduler in the Wi-Fi service while Wi-Fi is in use. The
    firmware switches Wi-Fi off along with the radio and rejoins on waking.
    Both services record the sleep in node_info.json (recorded_wake), so
    neither polls a sleeping node or counts it as missing; storage reports and
    sync also only go over the radio while it's the link in use.
    Battery saver (nodes.json "battery_saver": true; node_setup.py saver N
    on|off) keeps only the link in use powered (link_power.cpp): with the
    r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
2026-10-11 Wi-Fi on CircuitPython nodes; a full README guide to links and battery saver
    CircuitPython nodes on a Pico W / Pico 2 W can now use Wi-Fi, alone or
    with the radio (phase 4). wifi_link.py joins the network, connects to
    garden-wifi and stands in for the radio with PacketSender (one JSON line
    per packet), reporting why every 30 s while it can't join and rejoining
    by itself. link_power.py is the CircuitPython twin of link_power.cpp
    (battery saver, wifi_check_hours, the Pi's preferred link from polls).
    A Wi-Fi-only node skips the radio. node_config.py now says LINKS,
    BATTERY_SAVER and WIFI_CHECK_HOURS (and copes with no pins at all).
    node_setup.py gives a CircuitPython node its Wi-Fi settings by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
2026-10-12 CircuitPython nodes: a watchdog that resets a hung or crashed node
    node_watchdog.py starts the chip's watchdog (8 s, about the RP2040's
    longest) at the top of code.py, before the sensors and SD card are set
    up, so a bus hung by a corroded sensor resets the board even at startup.
    The loop feeds it on every pass, and so does every packet sent
    (communication_garden.feed) and every wait to join Wi-Fi or reach the Pi
    (wifi_link.feed); the Wi-Fi join is capped at 6 s to stay under it.
    If the code crashes it prints the error and resets after 5 s, instead of
    sitting at the REPL. Ctrl+C stops the watchdog so the console and
    node_setup.py's REPL use still work; a no_watchdog file on CIRCUITPY turns
    i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
2026-10-12 Wi-Fi polls skip late replies; CircuitPython backs off failed joins
    - A pong that arrives after its ping timed out could be read by the next
    poll and stored as a sensor reading (a "pong" row turned up for node 1).
    Polls now skip every reply that isn't a reading (NOT_READINGS).
    - CircuitPython's Wi-Fi rejoin attempts now back off from 30 s to 5
    minutes while they keep failing (as the M0's do): each attempt holds
    the loop, and the radio, for up to 6 s, which matters for a node with
    the radio first sitting out of Wi-Fi range.
2026-10-12 The Pi sets a node's link plan over the air: saver and prefer, no re-flash
    Every poll to a node with both links now carries its whole link plan,
    packed to fit a radio packet: "lp" is r or w for the link that comes
    first, a capital letter for battery saver, then the Wi-Fi check hours
    ("r", "R", "W", "R24"; replaces "pf", which only said the first link).
    Both firmwares apply it at once (link_power.cpp, link_power.py), so
    node_setup.py saver now takes effect at the next poll, like prefer,
    with nothing plugged in. After a restart a node uses what it was
    installed with until the first poll.
    The longest poll (node 254, R168) is 58 bytes, under the radio's 60; a
    test keeps it that way.
    README: th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
2026-10-12 node_setup.py: don't rewrite unchanged CircuitPython Wi-Fi settings, or wait for a node battery saver keeps off Wi-Fi
    Rewriting settings.toml restarted the node's code for nothing, and with
    battery saver on the radio first the node only turns Wi-Fi on for new
    settings, so setup would wait 60 s and report it hadn't connected.
2026-10-12 Arduino nodes: a watchdog that resets a hung node
    node_watchdog.cpp (Adafruit SleepyDog) is the Arduino twin of the
    CircuitPython watchdog: started in setup() before the radio, sensors and
    SD card; fed on every pass of loop(), with every packet sent
    (PacketSender::send_raw), before each Wi-Fi join or rejoin, before
    connecting to the Pi and before looking it up by name. 8 s, or 16 s on the
    M0, whose WiFi101 join alone waits up to 8 s. The M0's standby sleep lasts
    minutes between readings, so it's paused for standby and resumed on
    waking; the RP2 and ESP32 stay awake while "asleep" and feed it in that
    loop. After a watchdog reset the node says so at boot. -D NO_WATCHDOG
    leaves it off.
    Builds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
2026-10-12 garden-wifi: say when a node answers its polls with nothing to report
    A node with no sensors answering (node 2 on the bench) answers each poll
    with an empty batch_end, which logged nothing at all, so a working node
    looked silent. Now it's said once when that starts, and once when
    readings come back.
2026-10-13 CircuitPython nodes: sleep on the Pi's command
    A "sleep" command now gets a sleep_ack (refused if the clock isn't set, the
    wake time has passed or is over 16 h away), then the radio and Wi-Fi go off
    until the wake time while a reading is still logged every LOG_INTERVAL, as
    on the Arduino Pico nodes. On waking the links come back as link_power.py
    wants. The chip stays awake: CircuitPython's deeper sleeps restart code.py.
2026-10-14 garden-usb: pull a node's backlog when it's plugged into the Pi
    A new service (usb_sync.py --watch) watches the USB serial ports. A board
    that appears is asked for its info after 5 s, and if it has anything
    waiting its log is pulled over USB, once per plug-in. It stays off the ports
    while node_setup.py runs, and node_setup.py waits for a pull under way.
    install.sh, setup.sh and backup.sh know the fourth service.
2026-10-14 Dashboard: Refresh and ping test move into each node's row
    The header is now just the node chips (and °C/°F). Each node's row has its
    own ↺ refresh and ⇄ ping test buttons, its ping result, and its refresh
    progress strip; the row's note says which link it's reached over. On a
    phone the buttons get a line of their own under the node's name.
2026-10-14 Dashboard: the ping test opens a box in the node's row; Refresh is just ↺
    The ping test now shows its result in a closable box under the row's
    buttons, like Refresh's progress: a dot per ping (grey, teal on its way,
    green with its round trip, red no answer) and the average, fastest and
    slowest. Nothing in the row moves while it runs. The refresh button is
    just its arrow, which spins while a refresh runs. A Wi-Fi ping test clears
    the last test's progress first, so it can't show the old count.
2026-10-14 Low battery: a node with a LiPo sleeps through the day, checking in at dusk
    A node with a sleep window and a MAX17048 gauge whose newest battery
    reading (from the last 10 minutes) is under 25% while it's awake outside
    its window is sent back to sleep until 15 minutes before the window, so it
    checks in (a poll, some sync) before the window puts it to sleep for the
    night; the next morning's reading decides again. nodes.json
    "low_battery_sleep" changes the level per node, or false turns it off. Both
    services do it (whichever link is in use), and record why in node_info.json
    for the dashboard ("asleep until 18:45 (battery 18%, under 25%)").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
2026-10-14 Dashboard: a node row's note wraps instead of widening its column
    A long note (asleep until..., and why) set the width of the name column,
    squeezing the readings beside it into a narrow stack (and over the buttons).
    The note now wraps to the width of the name line.
2026-10-14 CircuitPython nodes take a failing sensor offline; the dashboard shows it
    sensor_guard.py: a sensor whose read fails or takes over 1 s three times in
    a row is no longer read, so a corroded connector can't hold up the rest of
    the bus; it's retried after 10 min, 30 min, then hourly, and one good read
    brings it back. The node lists its offline sensors in each poll answer
    ({"t":"off","s":"sht,s1"}); the Pi records them in node_info.json (not as
    readings) and logs the change; the dashboard puts a red "Offline since"
    banner on each one's card and lists them in the node's row. The VOC
    sensor's compensation now uses the SHT40 reading just taken instead of
    reading the SHT40 again.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
2026-10-14 Arduino nodes take a failing sensor offline too
    The twin of circuitpython/sensor_guard.py: each read function now says
    whether it worked (the SHT40's own result, 65535 from the seesaw, NaN from
    the MAX17048 and INA238, 0 from the SGP40), every read is timed, and three
    failed or slow (over 1 s) reads in a row take the sensor offline, retried
    after 10 min, 30 min, then hourly on clock_now() (which keeps counting
    through the M0's standby). Poll answers list the offline sensors in the
    same {"t":"off","s":...} packet, so the Pi and dashboard need nothing new.
    Built for feather_m0, feather_m0_wifi, picow and feather_esp32_v2.
2026-10-14 Low-battery day sleep only on a dark day, in 3-hour stretches
    A node with a low LiPo now sleeps through the day only when the weather
    forecasts agree the hours it would sleep through will be dark (every
    source that answered, at least two, averaging 75% cloud or more) and its
    own light sensor, if it has one, doesn't read 20,000 lux or more. garden-api
    fetches all five sources' hourly cloud cover every 30 minutes into
    /tmp/garden_weather_outlook.json (weather_outlook.py); the radio loop and
    garden-wifi only read it. Day sleeps last 3 hours at most, so a node checks
    in with fresh battery and light readings and the rest of the day is
    decided again; the last stretch still ends 15 minutes before i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
2026-10-14 Housekeeping: garden-radio, radio_nodes.py, working old tests, fewer leftovers
    - garden-sensor.service is now garden-radio.service, and main.py is
    radio_nodes.py: the radio counterpart of garden-wifi / wifi_nodes.py.
    install.sh disables and removes the old garden-sensor unit.
    - test_sync_garden.py and test_sync_indoor.py import the current modules
    again; tests of removed code are gone and three that described the old
    protocol now describe the current one. The whole suite runs with no
    --ignore.
    - New tests for flask_api.py (Refresh, its progress, sleeping nodes, node
    info; they need Flask, so they're skipped where it isn't installed) and
    set_interval.py. GARDEN_API_NO_THREADS=1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
2026-10-14 backup.sh and setup.sh: work on the SD card, not in /tmp
    /tmp is held in RAM on Raspberry Pi OS (about 450 MB on a Pi 3B), smaller
    than sensors.db alone, so the backup bundle ran out of room part-way
    through the archive. It's now put together in a hidden folder in the home
    directory, after checking the card has room for twice the data; restoring
    a bundle unpacks it there too.
2026-10-14 Dashboard: drag cards with a finger on phones (move, combine, split)
    Phones don't do native drag-and-drop, so a finger or pen now drags with
    pointer events from the same ⠿ handle (or a combined card's chips), with
    the same rules as the mouse: the middle of a card combines, its edges move
    it beside. In one column (a phone) the edges are the top and bottom, and
    the drop bar shows above or below. A label with the card's name follows
    the finger, and the page scrolls near the top and bottom of the screen. On
    touch screens the handle is bigger and always visible. The mouse's
    drag-and-drop shares the same aiming and finishing code.
2026-10-22 Radio nodes can send MessagePack instead of JSON, switched from the Pi
    nodes.json "radio_format": "msgpack" (node_setup.py format 3 msgpack, or
    json to go back) adds an "m" to the poll's lp code, and the node sends its
    radio packets as MessagePack from that poll on: the same keys, about a
    third smaller (30 bytes for a temperature/humidity reading instead of 45).
    No re-flash to switch either way; after a restart a node sends JSON until
    its first poll.
    - Pi: decode_packet() reads JSON (starts with "{") or MessagePack from any
    node, rounding 32-bit floats back to 7 digits; commands stay JSON. The
    radio venv needs msgpack (setup.sh installs it).
    - Arduino: serializeMsgPack on the radio send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
2026-10-22 Radio loop: log which format each node sends, and when it switches
    "[RADIO] Node 3 is sending MessagePack (30 bytes for its sht packet)."
    once when a node is first heard after a restart and again whenever it
    switches between JSON and MessagePack, so a radio_format change can be
    seen working from the Pi's log.
2026-10-22 Arduino: only this node's own radio commands carry its link settings
    Every node hears every radio command, and link_power_heard() ran before the
    check that a command is addressed to this node. So node 3 (no battery
    saver) took node 1's polls ("lp":"R") as its own: battery saver went on and
    off every minute and its Wi-Fi kept leaving and rejoining, and another
    node's commands counted as this node's link being used. CircuitPython
    already checked the node first.
2026-10-25 CircuitPython nodes keep notes on their SD card; the Pi collects them
    So a node that goes quiet in the garden can say why at its next sync or
    USB pull. node_events.py adds a {"t":"ev"} line to the SD log at every
    start (reset reason, CircuitPython version, USB or not), crash (the end of
    the error), console stop, sensor going offline or coming back, first
    failed radio send since starting, and radio format switch. They travel with
    the readings (radio sync or USB pull); the Pi takes them out before the
    database, logs them as [EVENT] and appends them to
    raspberrypi/node_events.txt. A packet the radio loop can't read is now
    logged with its size and first bytes.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
2026-10-25 Radio signal strength (RSSI) per node: in the log, the ping test and the dashboard
    The Pi's RFM69 measures how strongly each packet arrives. The radio loop
    now logs each node's average (and weakest) when first heard and every 5
    minutes, keeping it in node_info.json; the node's row shows RADIO SIGNAL
    (strong above -80 dBm, fair to -90, weak below), and the ping test reports
    its pongs' average. At 250 kbit/s packets start getting lost below about
    -90 dBm, so this tells a weak link (antenna, placement) from a node that's
    not sending at all.
2026-10-25 CircuitPython: notes when the radio stops sending or hearing, and when it recovers
    The radio library returns False when a send doesn't complete rather than
    raising, so a failing radio left no note. node_events.RadioWatch now notes
    the first failed send (False or an error) and when sends work again with
    how many failed, and when nothing at all has been heard over the radio for
    10 minutes and when it's heard again. Time with the radio off (battery
    saver, asleep) isn't counted as silence; anything received counts as heard.
2026-10-25 CircuitPython: read the sensors one at a time, checking the radio in between
    With its I2C sensors attached, node 1's pings dropped from about 8/10 to
    2/10: every sense cycle read all the sensors in one go (the light sensor
    waits for fresh measurements, corroded connections drag), and a ping that
    arrived meanwhile was answered after the Pi's 1.5 s wait. sense_cycle.py
    reads one sensor per pass of the loop, so the radio, USB and Wi-Fi are
    checked between reads; polls get the last complete snapshot meanwhile. The
    sensor guard still times each read and skips offline sensors. Asleep, with
    the radio off, the whole cycle still runs at once.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
2026-10-25 Arduino: read the sensors one at a time, checking the radio in between
    The Arduino twin of circuitpython/sense_cycle.py. RadioHead already catches
    every packet on the radio's interrupt, but the answer can't be sent from
    inside it, so a ping arriving mid-cycle waited for every sensor to be read.
    loop() now reads one sensor per pass (sense_cycle_start/step), into a
    staging set copied to latest_readings when the cycle finishes, so polls and
    the log always get a complete set. run_sense_cycle() still does a whole
    cycle at once for sleep. Built for feather_esp32_v2 (the ARM boards'
    compiler is currently blocked by Windows on the dev PC; the Pi builds them).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
2026-10-25 node_setup.py: messages give the exact commands to run, ready to copy
    "Node 3 has no RFM69 radio link (only Wi-Fi); adding one means re-flashing
    it with new settings" didn't say how. It now lists the commands, one per
    line (link 3 radio wifi, node_setup.py, restart garden-radio). The other
    messages that named a step without its full command (validation errors in
    nodes.py, a failed Wi-Fi hand-over, which node to set a board up as, the
    usage errors) now give it in full, with python3 in front.
2026-10-25 Radio signal history: stored every 5 minutes, averaged in the node row, plottable
    Each SignalWatch report (a node's average and weakest RSSI over 5 minutes)
    is now also stored as a reading, {"t":"sig","rssi","weakest"}, about 12 a
    node an hour. The node's row shows the latest with its average over the
    dashboard's 6 hours, the analysis panel offers Radio Signal (dBm) and Radio
    Signal · Weakest as fields, and Sensor Health doesn't count the readings as
    a sensor.
2026-10-26 node_setup.py: check the radio after setting a node up, and a pins command
    Setup flashed a node and checked it over USB, but never whether the Pi
    could reach it by radio, so wrong radio pins (the node starts anyway, over
    USB only) went unnoticed. After the sensor check, a node with the radio
    now gets a 5-ping test through garden-radio: "answers over the radio: 5/5
    pongs, -42 dBm", or the commands to see and fix its radio pins.
    node_setup.py check runs it too.
    node_setup.py pins 5 shows a node's pins; pins 5 radio_cs=6 radio_irq=11
    radio_rst=10 changes them (numbers for Arduino, names for CircuitPython),
    checked like the rest of nodes.json, then says how to re-flash.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
2026-10-27 The Pi's own power from its Witty Pi UPS: a dashboard chip, readings and power-cut notes
    garden-api reads the Witty Pi 4 L3V7 every 30 s (pi_power.py: I2C 0x08
    registers as UUGear's scripts read them, charger status on GPIO 5/6,
    through i2cget and pinctrl): whether the Pi is on its USB supply or the
    battery, the voltages and current, charging, and the Witty Pi's temperature.
    - The dashboard's Pi chip: green on USB power, amber on battery with a
    rough time left, red near the shutdown voltage, "power unknown" if stale.
    - Node 0's "pipwr" readings every 5 minutes (and at once on a change), so
    the analysis panel plots supply/battery voltage, current, on-battery and
    temperature.
    - A power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
2026-10-27 Pi chip: judge the Witty Pi reading's age on the Pi's own clock
    /api/node_info now includes the Pi's time ("now"), and the dashboard
    measures the power reading's age against it rather than the viewer's
    clock, so a Pi clock that's a few minutes off no longer shows "power
    unknown". The chip's tooltip says when the two clocks disagree by 2 min
    or more.
2026-10-27 The Pi's own chip beside the title, and a Pi row: power, vitals, radio links, health
    The Pi chip moves out of the node chips to sit beside the title (on a
    phone, on the title's line), light green, and opens the Pi's own row like
    a node chip does. The row shows its power and vitals (CPU temperature,
    load, memory, SD card, uptime), each node's radio signal (latest, average
    and weakest in view, when last heard), and its health: the four garden
    services, power-supply sag, CPU, storage, the clock's sync and the Witty
    Pi's temperature, from the new /api/pi_health (pi_health.py). The chip
    turns amber with a count when something there needs a look.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
2026-11-05 Dashboard: measure the Pi's timestamps against the Pi's time, in any time zone
    The Pi stamps everything in its own local time with no zone on it, so a
    device in another time zone read each stamp as hours off: "-10736s ago"
    on a phone three hours west, and packets wrongly trimmed from the data
    window on a device to the east.
    Every age, freshness, sleep and window check now goes through piNowMs(),
    the Pi's time from /api/node_info's "now", which is loaded before the
    windows are first set. The whole quarter hours of the offset count as
    time zone, so only what's left is reported as the Pi's clock being off.
    minutesAgo() replaces piAgo(). Dashboard only: nothing changes on the Pi.
    Co-Authored-B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
